sabinM1/VL53L8CX-carrier/reference docs/DB4884_VL53L8CX_Data_Brief.md

# DB4884 — VL53L8CX data brief

**Overview**
A summary brief highlighting the VL53L8CX capabilities: 60Hz framerate, 400cm range, low-power autonomous mode, and SPI/I2C connectivity for SLAM, gesture recognition, and laser-assisted autofocus (LAF). 

**System Diagram**
*[Image: Cover Image - Photograph of the top and bottom of the VL53L8CX module.]*
*[Image: Figure 1. VL53L8CX block diagram - High level internal component map showing the VCSEL, SPAD array, and control logic (identical to datasheet Figure 3).]*
