sabinM1/VL53L8CX-carrier/reference docs/Multizone_Cover_Window_Aperture_Calculator.md

# Multizone cover-window aperture calculator
[Image: A diagram illustrating Pitch and Roll angles relative to the sensor. The X dimension refers to the direction between emitter and transmitter. Pitch is the angle of deflection around the y-axis, and Roll is around the x-axis.][cite: 242]

**STMicroelectronics multizone Time-of-Flight aperture calculator**[cite: 242]

## Settings
| Item | Value | Description |
| :--- | :--- | :--- |
| **Sensor selection** | VL53L8 | Supported devices are VL53L5, L7, L8, L9[cite: 242] |
| **Coverglass thickness** | 1.00 | in millimeters[cite: 242] |
| **Coverglass refractive index** | 1.5 | no unit[cite: 242] |
| **Coverglass pitch y axis angle** | 0 | in degrees (not recommended)[cite: 242] |
| **Coverglass roll x axis angle** | 7 | in degrees[cite: 242] |
| **Airgap** | 0.81 | in millimeters[cite: 242] |
| **Airgap/gasket refractive index** | 1 | no unit[cite: 242] |
| **X, Y tolerances** | 300 | in micrometers[cite: 242] |
| **Z tolerance** | 0.2 | in millimeters[cite: 242] |
| **Rotation tolerance** | 0 | in degrees[cite: 242] |

## Results (Automatically Computed)
| Two circles (red circles) | Diameter (mm) | Circle center offset vs Optical axis (Xc) (mm) | Circle center offset vs Optical axis (Yc) (mm) |
| :--- | :--- | :--- | :--- |
| **Emitter** | 3.68 | 0.00 | 0.15[cite: 242] |
| **Receiver** | 3.64 | 0.00 | 0.14[cite: 242] |

| Single oval (blue shape) | Size (mm) | Circle center offset vs Optical axis (Xce) (mm) | Circle center offset vs Optical axis (Yce) (mm) |
| :--- | :--- | :--- | :--- |
| **Emitter** | 7.66 | 0.00 | 0.15[cite: 242] |
| **Receiver** | 3.68 | N/A | N/A[cite: 242] |

| Two rectangles (red) | X size (mm) | Y size (mm) | Rectangle center offset vs optical axis (Xc) (mm) | Rectangle center offset vs optical axis (Yc) (mm) |
| :--- | :--- | :--- | :--- | :--- |
| **Emitter** | 2.62 | 2.47 | 0.00 | 0.07[cite: 242] |
| **Receiver** | 2.59 | 2.44 | 0.00 | 0.07[cite: 242] |

| VL53L5CX/VL53L7/VL53L8 Single Rectangle | X size (mm) | Y size (mm) | Rectangle center offset vs optical axis (Xce) (mm) | Rectangle center offset vs optical axis (Yce) (mm) |
| :--- | :--- | :--- | :--- | :--- |
| **Aperture size** | 6.60 | 2.47 | 0.00 | 0.07[cite: 242] |
