sabinM1/VL53L8CX-carrier/reference docs/components/tps22918-q1.md

# TPS22918-Q1 — 5.5-V, 2-A, 52-mΩ On-Resistance Load Switch

Source file: `tps22918-q1.pdf`

## Features
- AEC-Q100 qualified
- Integrated single-channel load switch
- Qualified for automotive applications:
  - Device temperature grade 2: -40°C to +105°C ambient operating temperature range
- Functional safety capable
  - Documentation available to aid functional safety system design
- Input voltage range: 1 V to 5.5 V
- Low on-resistance (\(R_{ON}\)):
  - \(R_{ON} = 52\ \text{m}\Omega\) (typical) at \(V_{IN} = 5\ \text{V}\)
  - \(R_{ON} = 53\ \text{m}\Omega\) (typical) at \(V_{IN} = 3.3\ \text{V}\)
- 2-A maximum continuous switch current
- Low quiescent current:
  - \(8.3\ \mu\text{A}\) (typical) at \(V_{IN} = 3.3\ \text{V}\)
- Low-control input-threshold enables use of 1 V or higher GPIO
- Configurable Quick-Output Discharge (QOD)
- Configurable rise time with CT pin
- Small SOT23-6 package (DBV)
  - 2.9 mm × 2.8 mm, 0.95-mm pitch, 1.45-mm height (with leads)
- ESD performance tested per AEC-Q100
  - ±2-kV HBM and ±750-V CDM

## Applications
- Automotive electronics
- Infotainment
- Cluster
- ADAS (Advanced Driver Assistance Systems)

## Description
The TPS22918-Q1 is a single-channel load switch with both configurable rise time and configurable quick-output discharge. The device contains an N-channel MOSFET that operates over an input voltage range of 1 V to 5.5 V and supports a maximum continuous current of 2 A. The switch is controlled by an on/off input capable of interfacing directly with low-voltage control signals.

The configurable rise time reduces inrush current caused by large bulk load capacitances, reducing or eliminating power-supply droop. The TPS22918-Q1 features a configurable quick output discharge (QOD) pin that controls the fall time of the device to allow design flexibility for power down and sequencing.

The device is available in a small, leaded SOT-23 package (DBV) which allows visual inspection of solder joints. Characterized for operation over -40°C to +105°C free-air temperature range.

## Device Information

| Part Number | Package | Body Size (Nom) |
|---|---|---|
| TPS22918-Q1 | SOT-23 (6) | 2.90 mm × 1.60 mm |

## Pin Configuration and Functions

### DBV Package, 6-Pin SOT-23 (Top View)

| Pin | Name | Type | Description |
|---|---|---|---|
| 1 | VIN | I | Switch input. Place ceramic bypass capacitor(s) between this pin and GND. |
| 2 | GND | — | Device ground |
| 3 | ON | I | Active-high switch control input. Do not leave floating. |
| 4 | CT | O | Switch slew-rate control. Can be left floating. |
| 5 | QOD | O | Quick Output Discharge pin. Can be enabled by:<br>• External resistor between VOUT and QOD<br>• Tying QOD directly to VOUT using internal resistor \(R_{PD}\)<br>• Leaving pin disconnected to disable QOD |
| 6 | VOUT | O | Switch output |

## Absolute Maximum Ratings

Over operating free-air temperature range (unless otherwise noted).

| Parameter | Min | Max | Unit |
|---|---:|---:|---|
| \(V_{IN}\) input voltage | -0.3 | 6 | V |
| \(V_{OUT}\) output voltage | -0.3 | 6 | V |
| \(V_{ON}\) ON voltage | -0.3 | 6 | V |
| \(I_{MAX}\) maximum continuous switch current, \(T_A = 70°C\) | — | 2 | A |
| \(I_{MAX}\) maximum continuous switch current, \(T_A = 85°C\) | — | 1.5 | A |
| \(I_{PLS}\) maximum pulsed switch current, pulse < 300 µs, 2% duty cycle | — | 2.5 | A |
| \(T_J\) maximum junction temperature | — | 150 | °C |
| \(T_{stg}\) storage temperature | -65 | 150 | °C |

## ESD Ratings

| Rating | Value | Unit |
|---|---:|---|
| HBM per AEC Q100-002 | ±2000 | V |
| CDM per AEC Q100-011 | ±750 | V |

## Recommended Operating Conditions

Over operating free-air temperature range (unless otherwise noted).

| Parameter | Min | Max | Unit |
|---|---:|---:|---|
| \(V_{IN}\) input voltage | 1 | 5.5 | V |
| \(V_{ON}\) ON voltage | 0 | 5.5 | V |
| \(V_{OUT}\) output voltage | — | \(V_{IN}\) | V |
| \(V_{IH,ON}\) high-level input voltage, \(V_{IN}=1\ \text{V}\) to 5.5 V | 1 | 5.5 | V |
| \(V_{IL,ON}\) low-level input voltage, \(V_{IN}=1\ \text{V}\) to 5.5 V | 0 | 0.5 | V |
| \(T_A\) operating free-air temperature | -40 | 105 | °C |
| \(C_{IN}\) input capacitor | 1 | — | µF |

## Thermal Information

| Thermal Metric | DBV (SOT-23) 6 Pins | Unit |
|---|---:|---|
| \(R_{\theta JA}\) junction-to-ambient | 183.2 | °C/W |
| \(R_{\theta JC(top)}\) junction-to-case (top) | 151.6 | °C/W |
| \(R_{\theta JB}\) junction-to-board | 34.1 | °C/W |
| \(\Psi_{JT}\) junction-to-top characterization | 37.2 | °C/W |
| \(\Psi_{JB}\) junction-to-board characterization | 33.6 | °C/W |

## Electrical Characteristics

Unless otherwise noted, specifications apply over -40°C ≤ \(T_A\) ≤ +105°C (full). Typical values at \(T_A = 25°C\).

| Parameter | Test Conditions | \(T_A\) | Min | Typ | Max | Unit |
|---|---|---|---:|---:|---:|---|
| \(I_{Q,VIN}\) quiescent current | \(V_{IN}=5.5\ \text{V}\) | -40 to +105°C | — | 9.2 | 16 | µA |
| | \(V_{IN}=5\ \text{V}\) | | — | 8.7 | 16 | µA |
| | \(V_{IN}=3.3\ \text{V}\) | | — | 8.3 | 15 | µA |
| | \(V_{IN}=1.8\ \text{V}\) | | — | 10.2 | 17 | µA |
| | \(V_{IN}=1.2\ \text{V}\) | | — | 9.3 | 16 | µA |
| | \(V_{IN}=1\ \text{V}\) | | — | 8.9 | 15 | µA |
| \(I_{SD,VIN}\) shutdown current | \(V_{IN}=5.5\ \text{V}\) | -40 to +105°C | — | 0.5 | 5 | µA |
| | \(V_{IN}=5\ \text{V}\) | | — | 0.5 | 4.5 | µA |
| | \(V_{IN}=3.3\ \text{V}\) | | — | 0.5 | 3.5 | µA |
| | \(V_{IN}=1.8\ \text{V}\) | | — | 0.5 | 2.5 | µA |
| | \(V_{IN}=1.2\ \text{V}\) | | — | 0.4 | 2 | µA |
| | \(V_{IN}=1\ \text{V}\) | | — | 0.4 | 2 | µA |
| \(I_{ON}\) ON pin input leakage | \(V_{IN}=5.5\ \text{V}\), \(I_{OUT}=0\ \text{A}\) | -40 to +105°C | — | — | 0.1 | µA |
| \(R_{ON}\) on-resistance | \(V_{IN}=5.5\ \text{V}\), \(I_{OUT}=-200\ \text{mA}\) | 25°C | — | 51 | 59 | mΩ |
| | \(V_{IN}=5\ \text{V}\) | 25°C | — | 52 | 59 | mΩ |
| | \(V_{IN}=4.2\ \text{V}\) | 25°C | — | 52 | 59 | mΩ |
| | \(V_{IN}=3.3\ \text{V}\) | 25°C | — | 53 | 59 | mΩ |
| | \(V_{IN}=2.5\ \text{V}\) | 25°C | — | 53 | 61 | mΩ |
| | \(V_{IN}=1.8\ \text{V}\) | 25°C | — | 55 | 65 | mΩ |
| | \(V_{IN}=1.2\ \text{V}\) | 25°C | — | 64 | 77 | mΩ |
| | \(V_{IN}=1\ \text{V}\) | 25°C | — | 71 | 85 | mΩ |
| | \(V_{IN}=1\ \text{V}\) to 5.5 V | -40 to +105°C | — | — | 107 | mΩ |
| \(R_{PD}\) output pull-down resistance | \(V_{IN}=5\ \text{V}\), \(V_{ON}=0\ \text{V}\) | 25°C | — | 24 | — | Ω |
| | \(V_{IN}=3.3\ \text{V}\), \(V_{ON}=0\ \text{V}\) | 25°C | — | 25 | — | Ω |
| | \(V_{IN}=1.8\ \text{V}\), \(V_{ON}=0\ \text{V}\) | 25°C | — | 45 | — | Ω |
| | \(V_{IN}=1.8\ \text{V}\), \(V_{ON}=0\ \text{V}\) | -40 to +105°C | — | 60 | — | Ω |

## Switching Characteristics

See timing test circuit (Figure 21). \(V_{ON}=5\ \text{V}\), \(T_A=25°C\). Valid for power-up sequence where VIN is in steady state before ON is asserted high.

### \(V_{IN}=5\ \text{V}\)

| Parameter | Test Conditions | Min | Typ | Max | Unit |
|---|---|---|---:|---:|---|
| \(t_{ON}\) turn-on time | \(R_L=10\ \Omega\), \(C_{IN}=1\ \mu F\), \(C_{OUT}=0.1\ \mu F\), CT = 1000 pF | — | 1950 | — | µs |
| \(t_{OFF}\) turn-off time | same | — | 2 | — | µs |
| \(t_R\) \(V_{OUT}\) rise time | same | — | 2540 | — | µs |
| \(t_F\) \(V_{OUT}\) fall time | same | — | 2 | — | µs |
| \(t_D\) delay time | same | — | 690 | — | µs |

### \(V_{IN}=3.3\ \text{V}\)

| Parameter | Test Conditions | Min | Typ | Max | Unit |
|---|---|---|---:|---:|---|
| \(t_{ON}\) | same | — | 1430 | — | µs |
| \(t_{OFF}\) | same | — | 2 | — | µs |
| \(t_R\) | same | — | 1680 | — | µs |
| \(t_F\) | same | — | 2 | — | µs |
| \(t_D\) | same | — | 590 | — | µs |

### \(V_{IN}=1.8\ \text{V}\)

| Parameter | Test Conditions | Min | Typ | Max | Unit |
|---|---|---|---:|---:|---|
| \(t_{ON}\) | same | — | 965 | — | µs |
| \(t_{OFF}\) | same | — | 2 | — | µs |
| \(t_R\) | same | — | 960 | — | µs |
| \(t_F\) | same | — | 2 | — | µs |
| \(t_D\) | same | — | 480 | — | µs |

### \(V_{IN}=1\ \text{V}\)

| Parameter | Test Conditions | Min | Typ | Max | Unit |
|---|---|---|---:|---:|---|
| \(t_{ON}\) | same | — | 725 | — | µs |
| \(t_{OFF}\) | same | — | 3 | — | µs |
| \(t_R\) | same | — | 560 | — | µs |
| \(t_F\) | same | — | 2 | — | µs |
| \(t_D\) | same | — | 430 | — | µs |

## Typical DC Characteristics
- Quiescent current vs input voltage
- Shutdown current vs input voltage
- On-resistance vs temperature
- On-resistance vs input voltage
- On-resistance vs output current
- Hysteresis voltage vs input voltage

## Typical AC Characteristics
- Rise time vs input voltage
- Delay time vs input voltage
- Fall time vs input voltage
- Turnoff time vs input voltage
- Turnon time vs input voltage
- Rise/fall waveforms at \(V_{IN}\) = 5 V, 3.3 V, 1.8 V, 1 V

## Detailed Description

### Overview
The TPS22918-Q1 is a 5.5-V, 2-A load switch in a 6-pin SOT-23 package. It implements a low-resistance N-channel MOSFET to reduce dropout voltage. The configurable slew rate reduces or eliminates supply droop caused by large inrush currents. The QOD pin allows configuration of the VOUT discharge rate once the switch is disabled. During shutdown, leakage currents are very low. Integrated control logic, driver, charge pump, and output discharge FET reduce solution size and BOM count.

### Functional Block Diagram
- VIN → N-channel MOSFET → VOUT
- Charge pump drives the gate
- Control logic from ON pin
- CT pin sets slew rate
- QOD pin controls output discharge

### Feature Description

#### On and Off Control
The ON pin controls the switch state. ON is active high and has a low threshold, making it compatible with standard GPIO logic thresholds. It can interface with any microcontroller with 1 V or higher GPIO voltage. This pin cannot be left floating and must be driven high or low.

#### Quick Output Discharge (QOD)
The QOD pin can be configured in three ways:
1. **QOD pin shorted to VOUT** — discharge rate controlled by internal \(R_{PD}\).
2. **QOD pin connected to VOUT via external resistor \(R_{EXT}\)** — total QOD resistance:
   \[
   R_{QOD}=R_{PD}+R_{EXT}
   \]
3. **QOD pin left open** — QOD disabled.

#### Adjustable Rise Time (CT)
A capacitor to GND on the CT pin sets the slew rate. The CT capacitor must be rated for 25 V or above.

Approximate relationship:
\[
\text{SR}=0.55\times C_T+30
\]
where SR is slew rate in µs/V and \(C_T\) is capacitance in pF.

Rise time can be calculated by multiplying input voltage by the slew rate.

**Rise Time Table (Typical, 25°C, \(C_L=0.1\ \mu F\), \(C_{IN}=1\ \mu F\), \(R_L=10\ \Omega\), 25-V X7R 10% ceramic on CT):**

| \(C_T\) (pF) | \(V_{IN}\)=5 V | 3.3 V | 2.5 V | 1.8 V | 1.5 V | 1.2 V | 1.0 V | Unit |
|---|---:|---:|---:|---:|---:|---:|---:|---|
| 0 | 135 | 95 | 75 | 65 | 60 | 50 | 45 | µs |
| 220 | 650 | 450 | 350 | 260 | 220 | 185 | 160 | µs |
| 470 | 1260 | 850 | 655 | 480 | 415 | 340 | 300 | µs |
| 1000 | 2540 | 1680 | 1300 | 960 | 810 | 660 | 560 | µs |
| 2200 | 5435 | 3580 | 2760 | 2020 | 1715 | 1390 | 1220 | µs |
| 4700 | 12050 | 7980 | 6135 | 4485 | 3790 | 3120 | 2735 | µs |
| 10000 | 26550 | 17500 | 13460 | 9790 | 8320 | 6815 | 5950 | µs |

**Recommended CT Capacitor Voltage Rating:**

| \(V_{IN}\) (V) | Recommended CT Capacitor Voltage Rating (V) |
|---|---|
| 1 V to 1.2 V | 10 |
| 1.2 V to 4 V | 16 |
| 4 V to 5.5 V | 20 |

Note: If using \(V_{IN}=1.2\ \text{V}\) or 4 V, use the higher voltage rating.

### Device Functional Modes

| ON | QOD Configuration | VOUT Connection |
|---|---|---|
| L | QOD connected to VOUT with \(R_{EXT}\) | GND (via \(R_{EXT}+R_{PD}\)) |
| L | QOD tied to VOUT directly | GND (via \(R_{PD}\)) |
| L | QOD left open | Open |
| H | Any valid QOD configuration | VIN |

## Application and Implementation

### Typical Application
Power supply → VIN of TPS22918-Q1 → VOUT to downstream module.
- \(C_{IN}\) between VIN and GND
- \(C_L\) and \(R_L\) on VOUT
- CT capacitor to GND
- QOD configuration

### Design Requirements (Example)

| Design Parameter | Example Value |
|---|---|
| \(V_{IN}\) | 5 V |
| Load current | 2 A |
| \(C_L\) | 22 µF |
| \(t_F\) | 4 ms |
| Maximum acceptable inrush current | 400 mA |

### Detailed Design Procedure

#### Input Capacitor (\(C_{IN}\))
- A 1-µF ceramic capacitor placed close to VIN and GND is usually sufficient.
- For heavy loads, \(C_{IN}\) about 10× \(C_L\) is recommended to avoid excessive voltage drop.

#### Output Capacitor (\(C_L\)) (Optional)
- \(C_{IN} > C_L\) is highly recommended because of the MOSFET body diode.
- A \(C_L > C_{IN}\) can cause \(V_{OUT}\) to exceed \(V_{IN}\) when the supply is removed, causing current through the body diode from VOUT to VIN.
- A \(C_{IN}\):\(C_L\) ratio of 10:1 is recommended.

#### Shutdown Sequencing During Unexpected System Power Loss
- The QOD function can manage power-down sequencing in the event of unexpected system power loss (e.g., battery removal).
- Determine power-down order; check voltage/timing margins.
- Use QOD table to select \(C_{OUT}\) and \(R_{QOD}\) so fall times match the desired sequence.

Example (4 ms fall time, \(C_L=22\ \mu F\), \(V_{IN}=5\ \text{V}\)):
\[
5.5\ \text{V}=4.5\ \text{V}\times e^{-(4\text{ms})/(R\times 22\mu F)}
\]
\[
R_{QOD}=83.333\ \Omega
\]
With \(R_{PD}\approx 25\ \Omega\) at \(V_{IN}=5\ \text{V}\):
\[
83.333=R_{PD}+R_{EXT}\Rightarrow R_{EXT}=58.333\ \Omega
\]

#### \(V_{IN}\) to VOUT Voltage Drop
\[
\Delta V=I_{LOAD}\times R_{ON}
\]
Choose \(I_{LOAD}\) such that the \(I_{MAX}\) specification is not violated.

#### Inrush Current
\[
I_{INRUSH}=C_L\times\frac{dV_{OUT}}{dt}
\]
Example: \(C_L=22\ \mu F\), \(\Delta V=4\ \text{V}\), \(I_{INRUSH}\le 400\ \text{mA}\):
\[
dt\ge 220\ \mu s
\]
Choose CT yielding rise time > 220 µs. At \(V_{IN}=5\ \text{V}\), \(C_T=220\ \text{pF}\) gives ~650 µs typical rise time:
\[
I_{INRUSH}=22\ \mu F\times 4\ \text{V}/650\ \mu s\approx 135\ \text{mA}
\]

## Power Supply Recommendations
- \(V_{IN}\) range: 1 V to 5.5 V.
- Supply must be well regulated and placed close to the device with the recommended 1-µF bypass capacitor.
- If supply is more than a few inches away, additional bulk capacitance may be required (1 µF electrolytic, tantalum, or ceramic may suffice).

## Layout

### Layout Guidelines
- VIN and VOUT traces should be as short and wide as possible.
- Bypass VIN to GND with low-ESR ceramic capacitor (1 µF X5R/X7R), placed close to pins.
- Bypass VOUT to GND with low-ESR ceramic capacitor, typically one-tenth of the VIN bypass capacitor, placed close to pins.

### Thermal Considerations
- Maximum junction temperature must be ≤150°C.
- Maximum allowable power dissipation:
  \[
  P_{D(MAX)}=\frac{T_{J(MAX)}-T_A}{\theta_{JA}}
  \]
  where \(T_{J(MAX)}=150°C\) and \(\theta_{JA}\) is from the Thermal Information table.

## Device and Documentation Support

### Device Support
- TPS22918 PSpice Transient Model: SLVMB16

### Related Documentation
- TPS22918 5.5-V, 2-A, 50-mΩ On-Resistance Load Switch Evaluation Module, SLVUAP0
- Quiescent Current vs Shutdown Current for Load Switch Power Consumption, SLVA757
- Fundamentals of On-Resistance in Load Switches, SLVA771

### Trademarks
E2E is a trademark of Texas Instruments. All other trademarks are property of their respective owners.

### Electrostatic Discharge Caution
This integrated circuit can be damaged by ESD. Handle with appropriate precautions. ESD damage can range from subtle performance degradation to complete device failure.

## Mechanical, Packaging, and Orderable Information

### Package Option Addendum

| Orderable Part Number | Status | Package | Pins | Qty | Carrier | RoHS | Lead Finish | MSL/Peak Reflow | Op Temp (°C) | Part Marking |
|---|---|---|---|---:|---|---|---|---|---|---|
| TPS22918TDBVRQ1 | Active | SOT-23 (DBV) | 6 | 3000 | LARGE T&R | Yes | SN | Level-3-260C-168 HR | -40 to 105 | 13NW |
| TPS22918TDBVRQ1.A | Active | SOT-23 (DBV) | 6 | 3000 | LARGE T&R | Yes | SN | Level-3-260C-168 HR | -40 to 105 | 13NW |
| TPS22918TDBVTQ1 | Active | SOT-23 (DBV) | 6 | 250 | SMALL T&R | Yes | SN | Level-3-260C-168 HR | -40 to 105 | 13NW |
| TPS22918TDBVTQ1.A | Active | SOT-23 (DBV) | 6 | 250 | SMALL T&R | Yes | SN | Level-3-260C-168 HR | -40 to 105 | 13NW |

### Other Qualified Versions
- Catalog: TPS22918

### Tape and Reel Information (Nominal)

| Device | Package | Pins | SPQ | Reel Dia (mm) | Reel Width W1 (mm) | A0 (mm) | B0 (mm) | K0 (mm) | P1 (mm) | W (mm) | Pin1 Quadrant |
|---|---|---:|---:|---:|---:|---:|---:|---:|---:|---:|---|
| TPS22918TDBVRQ1 | SOT-23 (DBV) | 6 | 3000 | 178.0 | 9.0 | 3.23 | 3.17 | 1.37 | 4.0 | 8.0 | Q3 |
| TPS22918TDBVRQ1 | SOT-23 (DBV) | 6 | 3000 | 180.0 | 8.4 | 3.2 | 3.2 | 1.4 | 4.0 | 8.0 | Q3 |
| TPS22918TDBVTQ1 | SOT-23 (DBV) | 6 | 250 | 178.0 | 9.0 | 3.23 | 3.17 | 1.37 | 4.0 | 8.0 | Q3 |
| TPS22918TDBVTQ1 | SOT-23 (DBV) | 6 | 250 | 180.0 | 8.4 | 3.2 | 3.2 | 1.4 | 4.0 | 8.0 | Q3 |

### Tape and Reel Box Dimensions (Nominal)

| Device | Package | Pins | SPQ | Length (mm) | Width (mm) | Height (mm) |
|---|---|---:|---:|---:|---:|---:|
| TPS22918TDBVRQ1 | SOT-23 (DBV) | 6 | 3000 | 190.0 | 190.0 | 30.0 |
| TPS22918TDBVRQ1 | SOT-23 (DBV) | 6 | 3000 | 210.0 | 185.0 | 35.0 |
| TPS22918TDBVTQ1 | SOT-23 (DBV) | 6 | 250 | 190.0 | 190.0 | 30.0 |
| TPS22918TDBVTQ1 | SOT-23 (DBV) | 6 | 250 | 210.0 | 185.0 | 35.0 |

### Package Notes
- Linear dimensions in millimeters; values in parentheses are for reference only.
- Dimensioning and tolerancing per ASME Y14.5M.
- Body dimensions do not include mold flash/protrusion; max 0.25 mm per side.
- Leads 1,2,3 may be wider than leads 4,5,6 for package orientation.
- Reference JEDEC MO-178.
