sabinM1/VL53L8CX-carrier/reference docs/components/Taiyo_Yuden_MLCC_Catalog.md

# Taiyo Yuden Multilayer Ceramic Capacitors — Catalog Excerpt

Source file: `Taiyo Yuden_1102023_MC_mlcc_all_e.pdf`

## Reminders
- Product information is as of October 2021 and subject to change.
- Obtain and approve individual product specifications before use.
- Validate products in actual equipment and operating conditions.
- Taiyo Yuden is not responsible for damages caused by use outside specified conditions.
- Products are intended for general-purpose/standard use unless otherwise specified.

## Equipment Intended for Use
Product series are categorized by quality grade and intended application. Contact Taiyo Yuden before use in equipment requiring higher quality/reliability.

| Application | Product Series | Quality Grade |
|---|---|---|
| Automotive (POWERTRAIN, SAFETY) | A1 | 1 |
| Automotive (BODY & CHASSIS, INFOTAINMENT) | C2 | 2 |
| Industrial / Telecommunications infrastructure | B2 | 2 |
| Medical GHTF Class C (Japan Class III) | M2 | 2 |
| Medical GHTF Class A/B (Japan Class I/II) | L3 | 3 |
| Consumer general electronic equipment | S3 | 3 |

## Equipment Requiring Inquiry
Contact Taiyo Yuden before use in:
- Transportation equipment
- Traffic signal equipment
- Disaster/crime prevention equipment
- Medical devices classified as GHTF Class C (Japan Class III)
- Highly public information network equipment
- Other equipment requiring high quality/reliability

## Equipment Prohibited for Use
Do not use in:
- Aerospace equipment
- Aviation equipment (with limited exceptions)
- GHTF Class D / implantable medical devices
- Power generation control equipment
- Undersea equipment
- Military equipment
- Other extremely high-safety/reliability applications

## Part Number System
Example structure:
`MC A S 06 3 S B 7101 [F] C A01`

| Field | Meaning |
|---|---|
| (1) Series | MC = multilayer ceramic capacitor; MCAS/MCAR/MCJC/MCRL for automotive |
| (2) Category | C = automotive body/chassis/infotainment, quality grade 2 |
| (3) Rated voltage | A=4 V, J=6.3 V, L=10 V, E=16 V, T=25 V, G=35 V, U=50 V, H=100 V, Q=250 V, S=630 V |
| (4) Dimension | 06=0.6×0.3, 10=1.0×0.5, 16=1.6×0.8, 21=2.0×1.25, 31=3.2×1.6, 32=3.2×2.5, 45=4.5×3.2 |
| (5) Type | A = 2 terminals; J = soft termination; R = LW reversal |
| (6) Features | S = standard; R = high frequency/low loss; C = internal soft termination; L = low ESL |
| (7) Thickness | 3=0.3 mm, 5=0.5 mm, 7=0.7 mm, 8=0.8 mm, 9=0.85 mm, Q=1.15 mm, G=1.25 mm, L=1.6 mm, N=1.9 mm, M=2.5 mm |
| (8) Temperature characteristic | B5=X5R, B7=X7R, C6=X6S, C7=X7S, D7=X7T, CG/C0G, CH, CJ, CK |
| (9) Capacitance | 3-digit code, R = decimal point |
| (10) Tolerance | K=±10%, M=±20%, etc. |
| (11) Packaging | F, R, T, P |

## Temperature Characteristics

| Code | Standard | Temperature Range | Capacitance Change | Tolerance |
|---|---|---|---:|---|
| B5 | EIA X5R | -55°C to +85°C | ±15% | K ±10%, M ±20% |
| C6 | EIA X6S | -55°C to +105°C | ±22% | K ±10%, M ±20% |
| B7 | EIA X7R | -55°C to +125°C | ±15% | K ±10%, M ±20% |
| C7 | EIA X7S | -55°C to +125°C | ±22% | K ±10%, M ±20% |
| D7 | EIA X7T | -55°C to +125°C | +22%/-33% | K ±10%, M ±20% |

Temperature compensating types:
- CG/C0G: 0 ± 30 ppm/°C
- CH/C0H: 0 ± 60 ppm/°C
- CJ/C0J: 0 ± 120 ppm/°C
- CK/C0K: 0 ± 250 ppm/°C

## Nominal Capacitance Codes
Examples: 0R5 = 0.5 pF; 010 = 1 pF; 100 = 10 pF; 101 = 100 pF; 102 = 1 nF; 103 = 10 nF; 104 = 100 nF; 105 = 1 µF; 106 = 10 µF; 107 = 100 µF.

## Packaging Codes
- F: φ178 mm taping, 2 mm pitch
- R: φ178 mm embossed taping, 4 mm pitch
- T: φ178 mm taping, 4 mm pitch
- P: 3225 type, thickness code M, 1000 pcs/reel

## Part Number Tables
The catalog includes extensive part-number tables for:
- 0603 type, X7R, 0.3 mm thickness
- 1005 type, X5R, 0.5 mm thickness
- 1608 type, X5R/X7R, 0.8 mm thickness
- 2012 type, X5R/X7R, 1.25 mm thickness
- 3216 type, X5R/X7R, 1.6 mm thickness
- 3225 type, X5R/X7R, 2.5 mm and 1.9 mm thickness
- Soft-termination MLCCs
- LW reversal low-ESL capacitors

## Key Electrical/Test Requirements
- Operating temperature range: -55°C to +125°C for Class 1; Class 2 depends on dielectric.
- Storage: ≤30°C, ≤70% RH recommended; use within 6 months of delivery.
- Rated voltage: 4 V to 630 V depending on series.
- Withstanding voltage: Class 1 = 3× rated (or 2× for high-frequency type); Class 2 = 2.5× rated.
- Insulation resistance: Class 1 ≥10,000 MΩ; Class 2 ≥10,000 MΩ for C≤0.047 µF, or 500 MΩ·µF for C>0.047 µF.
- Capacitance tolerance: Class 1 ±0.25 pF, ±0.5 pF, ±5%; Class 2 ±10%, ±20%.
- Q/DF: Class 1 Q≥400+20C (C<30 pF), Q≥1000 (C≥30 pF); Class 2 DF ≤2.5% typical.
- Endurance, temperature cycling, humidity, soldering heat, vibration, mechanical shock, board flex tested per AEC-Q200 and IEC standards.
