sabinM1/VL53L8CX-carrier/reference docs/components/TDK_MLCC_Commercial_Capacitors.md

# TDK MLCC — Commercial Grade General Capacitors (Up to 75 V), C Series

Source file: `mlcc_commercial_general_en.pdf`

## Series Overview
General-purpose surface-mount multilayer ceramic chip capacitors. Monolithic structure gives high mechanical strength, high reliability, low ESR, and low ESL. Capacitance range up to 220 µF.

## Features
- Superior mechanical strength and high reliability
- Outstanding frequency characteristics: low ESR, low ESL
- Low self-heating and high ripple resistance due to low ESR
- No polarity

## Applications
- General electronic equipment
- Mobile devices
- Servers, PCs, tablets
- Power supply circuits

## Shape and Dimensions

| Type | L (mm) | W (mm) | T (mm) | B min (mm) | G min (mm) |
|---|---:|---:|---:|---:|---:|
| C0402 [CC01005] | 0.40 ± 0.02 | 0.20 ± 0.02 | 0.20 ± 0.02 | 0.07 | 0.14 |
| C0603 [CC0201] | 0.60 ± 0.03 | 0.30 ± 0.03 | 0.30 ± 0.03 | 0.10 | 0.20 |
| C1005 [CC0402] | 1.00 ± 0.05 | 0.50 ± 0.05 | 0.50 ± 0.05 | 0.30 | — |
| C1608 [CC0603] | 1.60 ± 0.10 | 0.80 ± 0.10 | 0.80 ± 0.10 | 0.30 | — |
| C2012 [CC0805] | 2.00 ± 0.20 | 1.25 ± 0.20 | 1.25 ± 0.20 | 0.50 | — |
| C3216 [CC1206] | 3.20 ± 0.20 | 1.60 ± 0.20 | 1.60 ± 0.20 | 1.00 | — |
| C3225 [CC1210] | 3.20 ± 0.40 | 2.50 ± 0.30 | 2.50 ± 0.30 | — | — |
| C4532 [CC1812] | 4.50 ± 0.40 | 3.20 ± 0.40 | 3.20 ± 0.40 | — | — |
| C5750 [CC2220] | 5.70 ± 0.40 | 5.00 ± 0.40 | 2.80 ± 0.30 | — | — |

## Temperature Characteristics

| Code | Capacitance Change | Temperature Range |
|---|---|---|
| C0G | 0 ± 30 ppm/°C | -55°C to +125°C |
| X7R | ±15% | -55°C to +125°C |
| X7S | ±22% | -55°C to +125°C |
| X7T | +22% / -33% | -55°C to +125°C |
| X6S | ±22% | -55°C to +105°C |
| X5R | ±15% | -55°C to +85°C |
| X5S | ±22% | -55°C to +85°C |

## Rated Voltage Codes

| Code | Voltage |
|---|---:|
| 0E | 2.5 V |
| 0G | 4 V |
| 0J | 6.3 V |
| 1A | 10 V |
| 1C | 16 V |
| 1E | 25 V |
| 1V | 35 V |
| 1H | 50 V |
| 1N | 75 V |

## Capacitance Tolerance

| Code | Tolerance |
|---|---|
| B | ±0.10 pF |
| C | ±0.25 pF |
| D | ±0.50 pF |
| F | ±1% |
| G | ±2% |
| J | ±5% |
| K | ±10% |
| M | ±20% |

## Nominal Thickness Codes
020 = 0.20 mm; 030 = 0.30 mm; 050 = 0.50 mm; 060 = 0.60 mm; 080 = 0.80 mm; 085 = 0.85 mm; 115 = 1.15 mm; 125 = 1.25 mm; 160 = 1.60 mm; 200 = 2.00 mm; 230 = 2.30 mm; 250 = 2.50 mm; 280 = 2.80 mm; 320 = 3.20 mm.

## Packaging Style
- A: 178 mm reel, 4 mm pitch
- B: 178 mm reel, 2 mm pitch
- K: 178 mm reel, 8 mm pitch

## Capacitance Range Summary
The catalog contains detailed capacitance range charts and tables for COG, X5R, X6S, X7R, X7S, X5S, X7T across sizes from 0402 to 5750. Representative ranges:
- COG: 1 pF to 220 nF depending on size/voltage
- X5R: 100 pF to 220 µF
- X6S: 2.2 nF to 220 µF
- X7R: 100 pF to 47 µF
- X7S: 100 nF to 47 µF
- X7T: 10 µF to 220 µF

## Notes
- Gray entries in original tables are NRND (Not Recommended for New Designs).
- Capacitance values outside E-6 series available on request.
- Dimensions are typical; check product page for actual values.
