sabinM1/VL53L8CX-carrier/reference docs/components/Yageo_AC_AEC-Q200_Resistors.md

# Yageo AC Series — AEC-Q200 Chip Resistors

Source file: `PYu-AC_51_RoHS_L_11.pdf`

## Scope
AC0201 to AC2512 chip resistors with lead-free terminations, thick-film process.

## Applications
- All general-purpose applications
- Car electronics
- Industrial applications

## Features
- AEC-Q200 qualified
- MSL 1
- Soldering compliant with J-STD-020D
- Halogen-free epoxy
- RoHS compliant
- Pb-glass exempted by RoHS
- High component and equipment reliability
- 100% automatic optical inspection before taping

## Ordering Information — Global Part Number
Format:
`AC XXXX X X X X XXXX L`

| Field | Meaning |
|---|---|
| (1) Size | 0201/0402/0603/0805/1206/1210/1218/2010/2512 |
| (2) Tolerance | B=±0.1% low TCR; D=±0.5%; F=±1%; J=±5% |
| (3) Packaging | R=paper taping reel; K=embossed taping reel |
| (4) TCR | E=±50 ppm/°C |
| (5) Reel | 07=7-in standard; 7W=7-in 2× power; 13=13-in; 3W=13-in 2× power |
| (6) Resistance | 1 Ω–22 MΩ; R/K/M = decimal point |
| (7) Default | B = bulk AOI ordering only |

Example: `AC0402FR-07100KL` = AC0402, ±1%, 7-in reel, 100 kΩ.

## Marking
- AC0201/0402: no marking
- AC0603/0805/1206/1210/2010/2512:
  - E-24 ±5%: 3 digits
  - E-96 ±1%, ±0.5%: E-96 marking
- AC0805/1206/1210/2010/2512:
  - ±1%, ±0.5%: 4 digits
- AC1218:
  - E-24 ±5%: 3 digits
  - ±1%, ±0.5%: 4 digits

## Construction
Automotive-grade ceramic body, internal metal electrodes, resistive glaze, protective glass, laser trimming, protective overcoat, Ni/matte tin terminations.

## Dimensions

| Type | L (mm) | W (mm) | H (mm) | I1 (mm) | I2 (mm) |
|---|---:|---:|---:|---:|---:|
| AC0201 | 0.60 ± 0.03 | 0.30 ± 0.03 | 0.23 ± 0.03 | 0.12 ± 0.05 | 0.15 ± 0.05 |
| AC0402 | 1.00 ± 0.05 | 0.50 ± 0.05 | 0.32 ± 0.05 | 0.20 ± 0.10 | 0.25 ± 0.10 |
| AC0603 | 1.60 ± 0.10 | 0.80 ± 0.10 | 0.45 ± 0.10 | 0.25 ± 0.15 | 0.25 ± 0.15 |
| AC0805 | 2.00 ± 0.10 | 1.25 ± 0.10 | 0.50 ± 0.10 | 0.35 ± 0.20 | 0.35 ± 0.20 |
| AC1206 | 3.10 ± 0.10 | 1.60 ± 0.10 | 0.55 ± 0.10 | 0.45 ± 0.20 | 0.45 ± 0.20 |
| AC1210 | 3.10 ± 0.10 | 2.60 ± 0.15 | 0.55 ± 0.10 | 0.45 ± 0.15 | 0.50 ± 0.20 |
| AC1218 | 3.10 ± 0.10 | 4.60 ± 0.10 | 0.55 ± 0.10 | 0.45 ± 0.20 | 0.40 ± 0.20 |
| AC2010 | 5.00 ± 0.10 | 2.50 ± 0.15 | 0.55 ± 0.10 | 0.55 ± 0.15 | 0.55 ± 0.20 |
| AC2512 | 6.35 ± 0.10 | 3.10 ± 0.15 | 0.55 ± 0.10 | 0.60 ± 0.20 | 0.60 ± 0.20 |

## Electrical Characteristics (Representative)

| Type | Power | Operating Temp | Max Working Voltage | Max Overload Voltage | Resistance Range | TCR |
|---|---:|---|---:|---:|---|---|
| AC0201 | 1/20 W | -55°C to +155°C | 25 V | 50 V | 1 Ω–10 MΩ | -100/+350 ppm/°C |
| AC0402 | 1/16 W | -55°C to +155°C | 50 V | 100 V | 1 Ω–22 MΩ | ±200/±100 ppm/°C |
| AC0603 | 1/10 W | -55°C to +155°C | 75 V | 150 V | 1 Ω–22 MΩ | ±200/±100 ppm/°C |
| AC0805 | 1/8 W | -55°C to +155°C | 150 V | 300 V | 1 Ω–22 MΩ | ±200/±100 ppm/°C |
| AC1206 | 1/4 W | -55°C to +155°C | 200 V | 400 V | 1 Ω–10 MΩ | ±200/±100 ppm/°C |
| AC1210 | 1/2 W | -55°C to +155°C | 200 V | 500 V | 1 Ω–10 MΩ | ±200/±100 ppm/°C |
| AC1218 | 1 W / 1.5 W | -55°C to +155°C | 200 V | 500 V | 1 Ω–1 MΩ | ±200/±100 ppm/°C |
| AC2010 | 3/4 W / 1.25 W | -55°C to +155°C | 200 V | 500 V | 1 Ω–22 MΩ | ±200/±100 ppm/°C |
| AC2512 | 1 W / 2 W | -55°C to +155°C | 200 V | 500 V | 1 Ω–22 MΩ | ±200/±100 ppm/°C |

Low-TCR versions: ±50 ppm/°C, resistance range 10 Ω to 1 MΩ depending on size and power.

## Packing Style and Quantity

| Size | Paper reel 7-in | Paper reel 13-in | Embossed 7-in | Embossed 13-in |
|---|---:|---:|---:|---:|
| AC0201 | 10,000 | 50,000 | — | — |
| AC0402 | 10,000 | 50,000 | — | — |
| AC0603 | 5,000 | 20,000 | — | — |
| AC0805 | 5,000 | 20,000 | — | — |
| AC1206 | 5,000 | 20,000 | — | — |
| AC1210 | 5,000 | 20,000 | — | — |
| AC1218 | — | — | 4,000 | 16,000 |
| AC2010 | — | — | 4,000 | 16,000 |
| AC2512 | — | — | 4,000 | 16,000 |

## Tests and Requirements
AEC-Q200 tests include:
- High-temperature exposure
- Moisture resistance
- Biased humidity
- Operational life
- Resistance to soldering heat
- Thermal shock
- ESD
- Solderability
- Board flex
- TCR
- Short-time overload
- FOS (sulfur resistance)
