sabinM1/VL53L8CX-carrier/reference docs/components/Yageo_RC_L_General_Purpose_Resistors.md

# Yageo RC_L Series — General-Purpose Chip Resistors

Source file: `PYU-RC_GROUP_51_ROHS_L.pdf`

## Scope
RC series chip resistors with lead-free terminations, thick-film process.

## Applications
All general-purpose applications.

## Features
- Halogen-free epoxy
- RoHS compliant
- Lead-free terminations meet RoHS requirements
- Pb-glass in electrodes/resistor element/glass exempted by RoHS
- High component and equipment reliability
- Saves PCB space
- MSL class: MSL 1

## Ordering Information — Global Part Number
Format:
`RC XXXXX X X X X XXXX L`

| Field | Meaning |
|---|---|
| (1) Size | 0075/0100/0201/0402/0603/0805/1206/1210/1218/2010/2512 |
| (2) Tolerance | B=±0.1%, D=±0.5%, F=±1.0%, J=±5.0% |
| (3) Packaging | R=paper taping reel; K=embossed taping reel; S=ESD-safe reel (0075/0100 only) |
| (4) TCR | Based on spec |
| (5) Reel/power | 07=7-in standard; 10=10-in; 13=13-in; 7W=7-in 2× standard power; 7D=7-in 2× standard quantity; 7N=7-in ESD-safe; 3W=13-in 2× standard power |
| (6) Resistance | 2–4 digits; R/K/M = decimal point; e.g. 97R6=97.6 Ω, 9K76=9.76 kΩ, 1M=1 MΩ |
| (7) Default | L |

Example: `RC0402JR-07100KL` = RC0402, ±5%, 7-in reel, 100 kΩ.

## Marking
- RC0075/0100/0201/0402: no marking
- RC0603:
  - 1%, 0.5%, E24 exception values: 3 digits
  - 1%, 0.5%, E96: EIA-96 marking
  - 5%, E24: 3 digits
- RC0805/1206/1210/2010/2512:
  - 1%, 0.5%: 4 digits
  - 5%: 3 digits
- RC1218:
  - E-24 ±5%: 3 digits
  - E-24/E-96 ±1%, ±0.5%: 4 digits

## Construction
High-grade ceramic body, internal metal electrodes, thick-film resistive element, laser trimmed, protective epoxy coat, matte tin over Ni barrier terminations.

## Dimensions

| Type | L (mm) | W (mm) | H (mm) | l1 (mm) | l2 (mm) |
|---|---:|---:|---:|---:|---:|
| RC0075 | 0.30 ± 0.01 | 0.15 ± 0.01 | 0.13 ± 0.01 | 0.08 ± 0.03 | 0.08 ± 0.03 |
| RC0100 | 0.40 ± 0.02 | 0.20 ± 0.02 | 0.13 ± 0.02 | 0.10 ± 0.03 | 0.10 ± 0.03 |
| RC0201 | 0.60 ± 0.03 | 0.30 ± 0.03 | 0.23 ± 0.03 | 0.10 ± 0.05 | 0.15 ± 0.05 |
| RC0402 | 1.00 ± 0.05 | 0.50 ± 0.05 | 0.35 ± 0.05 | 0.20 ± 0.10 | 0.25 ± 0.10 |
| RC0603 | 1.60 ± 0.10 | 0.80 ± 0.10 | 0.45 ± 0.10 | 0.25 ± 0.15 | 0.25 ± 0.15 |
| RC0805 | 2.00 ± 0.10 | 1.25 ± 0.10 | 0.50 ± 0.10 | 0.35 ± 0.20 | 0.35 ± 0.20 |
| RC1206 | 3.10 ± 0.10 | 1.60 ± 0.10 | 0.55 ± 0.10 | 0.45 ± 0.20 | 0.45 ± 0.20 |
| RC1210 | 3.10 ± 0.10 | 2.60 ± 0.15 | 0.55 ± 0.10 | 0.45 ± 0.15 | 0.50 ± 0.20 |
| RC1218 | 3.10 ± 0.10 | 4.60 ± 0.10 | 0.55 ± 0.10 | 0.45 ± 0.20 | 0.40 ± 0.20 |
| RC2010 | 5.00 ± 0.10 | 2.50 ± 0.15 | 0.55 ± 0.10 | 0.60 ± 0.20 | 0.55 ± 0.20 |
| RC2512 | 6.35 ± 0.10 | 3.10 ± 0.15 | 0.55 ± 0.10 | 0.60 ± 0.20 | 0.60 ± 0.20 |

## Electrical Characteristics (Representative)

| Type | Power | Operating Temp | Max Working Voltage | Max Overload Voltage | Resistance Range | TCR |
|---|---:|---|---:|---:|---|---|
| RC0201 | 1/20 W | -55°C to +125°C | 25 V | 50 V | 1 Ω–100 MΩ | -100 to +350 ppm/°C |
| RC0402 | 1/16 W | -55°C to +155°C | 50 V | 100 V | 1 Ω–100 MΩ | ±200/±100 ppm/°C |
| RC0603 | 1/10 W | -55°C to +155°C | 75 V | 150 V | 1 Ω–22 MΩ | ±200/±100 ppm/°C |
| RC0805 | 1/8 W | -55°C to +155°C | 150 V | 300 V | 1 Ω–100 MΩ | ±200/±100 ppm/°C |
| RC1206 | 1/4 W | -55°C to +155°C | 200 V | 400 V | 1 Ω–100 MΩ | ±200/±100 ppm/°C |
| RC1210 | 1/2 W | -55°C to +155°C | 200 V | 500 V | 1 Ω–100 MΩ | ±200/±100 ppm/°C |
| RC1218 | 1 W | -55°C to +155°C | 200 V | 500 V | 1 Ω–1 MΩ | ±200/±100 ppm/°C |
| RC2010 | 3/4 W | -55°C to +155°C | 200 V | 500 V | 1 Ω–22 MΩ | ±200/±100 ppm/°C |
| RC2512 | 1 W / 2 W | -55°C to +155°C | 200 V | 500 V | 1 Ω–22 MΩ | ±200/±100 ppm/°C |

Jumper criteria: <50 mΩ, rated current 0.5 A to 10 A depending on size.

## Rated Voltage
\[
V=\sqrt{P\times R}
\]
or maximum working voltage, whichever is less.

## Power Derating
Rated power at 70°C; derate linearly to zero at 125°C or 155°C depending on size.

## Tests and Requirements
Includes:
- TCR
- Life/endurance
- High-temperature exposure
- Moisture resistance
- Humidity
- Thermal shock
- Short-time overload
- Board flex/bending
- Solderability
- Leaching
- Resistance to soldering heat
