sabinM1/VL53L8CX-carrier/reference docs/components/Yageo_RE_Precision_Resistors.md

# Yageo RE Series — Precision-Grade Thick-Film Chip Resistors

Source file: `pyu-re_105_rohs_l.pdf`

## Scope
RE0201 to RE1206 ultra-precision chip resistors with lead-free terminations, thick-film process.

## Applications
- Converters
- Printer equipment
- Server boards
- Telecom
- Consumer

## Features
- Halogen-free epoxy
- RoHS compliant
- High component and equipment reliability
- Non-forbidden materials
- MSL 1

## Ordering Information — Global Part Number
Format:
`RE XXXX X X XXXX L`

| Field | Meaning |
|---|---|
| (1) Size | 0201/0402/0603/0805/1206 |
| (2) Tolerance | B=±0.1%, D=±0.5%, F=±1% |
| (3) Packaging | R = paper/PE taping reel |
| (4) TCR | E = ±50 ppm/°C |
| (5) Reel | 07=7-in, 10=10-in, 13=13-in |
| (6) Resistance | 2–4 digits; R/K/M = decimal point |
| (7) Default | L |

Example: `RE0603DRE0756RL` = RE0603, ±0.5%, TC50, 56 Ω, 7-in reel.

## Marking
- RE0201/0402: no marking
- RE0603:
  - 1%, 0.5%, 0.1% E24 exception values: 3 digits
  - E96: EIA-96 marking
- RE0805/1206: 4 digits (E24 or E96)

## Construction
High-grade ceramic body, internal metal electrodes, resistive layer, laser trimming, protective coat, matte tin terminations.

## Dimensions

| Type | L (mm) | W (mm) | H (mm) | I1 (mm) | I2 (mm) |
|---|---:|---:|---:|---:|---:|
| RE0201 | 0.60 ± 0.03 | 0.30 ± 0.03 | 0.23 ± 0.03 | 0.10 ± 0.05 | 0.15 ± 0.05 |
| RE0402 | 1.00 ± 0.05 | 0.50 ± 0.05 | 0.32 ± 0.05 | 0.20 ± 0.10 | 0.25 ± 0.10 |
| RE0603 | 1.60 ± 0.10 | 0.80 ± 0.10 | 0.45 ± 0.10 | 0.25 ± 0.15 | 0.25 ± 0.15 |
| RE0805 | 2.00 ± 0.10 | 1.25 ± 0.10 | 0.50 ± 0.10 | 0.35 ± 0.20 | 0.35 ± 0.20 |
| RE1206 | 3.10 ± 0.10 | 1.60 ± 0.10 | 0.55 ± 0.10 | 0.45 ± 0.20 | 0.45 ± 0.20 |

## Electrical Characteristics

| Type | Resistance Range | Operating Temp | Power Rating | Max Working Voltage | Dielectric Withstand | Max Overload | TCR |
|---|---|---:|---:|---:|---:|---:|---|
| RE0201 | 100 Ω–1 MΩ | -55°C to +155°C | 1/20 W | 25 V | 50 V | 50 V | ±50 ppm/°C |
| RE0402 | 10 Ω–1 MΩ | -55°C to +155°C | 1/16 W | 50 V | 100 V | 100 V | ±50 ppm/°C |
| RE0603 | 10 Ω–1 MΩ | -55°C to +155°C | 1/10 W | 75 V | 150 V | 150 V | ±50 ppm/°C |
| RE0805 | 10 Ω–1 MΩ | -55°C to +155°C | 1/8 W | 150 V | 300 V | 300 V | ±50 ppm/°C |
| RE1206 | 10 Ω–1 MΩ | -55°C to +155°C | 1/4 W | 200 V | 500 V | 400 V | ±50 ppm/°C |

## Rated Voltage
\[
V=\sqrt{P\times R}
\]
or maximum working voltage, whichever is less.

## Packing Style and Quantity

| Size | 7-in | 10-in | 13-in |
|---|---:|---:|---:|
| RE0201 | 10,000 | 20,000 | 50,000 |
| RE0402 | 10,000 | 20,000 | 50,000 |
| RE0603 | 5,000 | 10,000 | 20,000 |
| RE0805 | 5,000 | 10,000 | 20,000 |
| RE1206 | 5,000 | 10,000 | 20,000 |

## Tests and Requirements
Includes:
- Life/endurance
- High-temperature exposure
- Moisture resistance
- Thermal shock
- Short-time overload
- Board flex/bending
- Humidity
- Solderability
- Leaching
- Resistance to soldering heat
