sabinM1/VL53L8CX-carrier/reference docs/components/Yageo_X5R_MLCC_Capacitors.md

# Yageo X5R MLCC — Surface Mount Multilayer Ceramic Capacitors, 4 V to 50 V

Source file: `upy-gphc_x5r_4v-to-50v.pdf`

## Scope
X5R series chip capacitors with lead-free terminations.

## Applications
- PCs, hard disk, game PCs
- Power supplies
- DVD players
- Mobile phones
- Data processing

## Features
- Supplied in tape on reel
- Nickel-barrier end termination
- RoHS compliant
- Halogen free

## Ordering Information — Global Part Number
Format:
`CC XXXX X X X5R X BB XXX`

| Field | Meaning |
|---|---|
| (1) Size | 0201 (0603), 0402 (1005), 0603 (1608), 0805 (2012), 1206 (3216), 1210 (3225) |
| (2) Tolerance | K = ±10%, M = ±20% |
| (3) Packing | R = paper/PE 7-in reel; K = blister 7-in; P = paper/PE 13-in; F = blister 13-in; C = bulk |
| (4) Rated voltage | 4 = 4 V; 5 = 6.3 V; 6 = 10 V; 7 = 16 V; 8 = 25 V; 9 = 50 V |
| (5) Capacitance | 2 significant digits + zeros; R = decimal point; e.g. 103 = 10 nF |

## Construction
Rectangular ceramic dielectric block with interleaved metal electrodes; inner electrodes connected to end terminations; plated tin (NiSn); lead-free.

## Dimensions

| Type | L1 (mm) | W (mm) | T (mm) | L2/L3 (mm) | L4 min (mm) | Code |
|---|---|---|---:|---:|---:|---|
| 0201 | 0.6 ± 0.03 | 0.3 ± 0.03 | 0.3 ± 0.03 | 0.10–0.20 | 0.2 | BA |
| 0201 | 0.6 ± 0.05 | 0.3 ± 0.05 | 0.3 ± 0.05 | 0.10–0.20 | 0.2 | BB |
| 0201 | 0.6 ± 0.09 | 0.3 ± 0.09 | 0.3 ± 0.09 | 0.10–0.25 | 0.2 | BC |
| 0201 | 0.6 ± 0.15 | 0.3 ± 0.15 | 0.3 ± 0.15 | 0.10–0.25 | 0.2 | BD |
| 0402 | 1.0 ± 0.05 | 0.5 ± 0.05 | 0.5 ± 0.05 | 0.15–0.35 | 0.3 | CA |
| 0402 | 1.0 ± 0.10 | 0.5 ± 0.10 | 0.5 ± 0.10 | 0.15–0.35 | 0.3 | CB |
| 0402 | 1.0 ± 0.15 | 0.5 ± 0.15 | 0.5 ± 0.15 | 0.15–0.35 | 0.3 | CC |
| 0402 | 1.0 ± 0.20 | 0.5 ± 0.20 | 0.5 ± 0.20 | 0.15–0.35 | 0.3 | CD |
| 0603 | 1.6 ± 0.10 | 0.8 ± 0.10 | 0.8 ± 0.10 | 0.20–0.60 | 0.4 | DA |
| 0603 | 1.6 ± 0.15 | 0.8 ± 0.15 | 0.8 ± 0.15 | 0.20–0.60 | 0.4 | DB |
| 0603 | 1.6 ± 0.20 | 0.8 ± 0.20 | 0.8 ± 0.20 | 0.20–0.60 | 0.4 | DC |
| 0805 | 2.0 ± 0.20 | 1.25 ± 0.20 | 0.85 ± 0.10 | 0.25–0.75 | 0.7 | EA |
| 0805 | 2.0 ± 0.20 | 1.25 ± 0.20 | 1.25 ± 0.20 | 0.25–0.75 | 0.7 | EB |
| 1206 | 3.2 ± 0.20 | 1.6 ± 0.20 | 1.15 ± 0.10 | 0.25–0.75 | 1.4 | FA |
| 1206 | 3.2 ± 0.30 | 1.6 ± 0.20 | 1.25 ± 0.20 | 0.25–0.75 | 1.4 | FB |
| 1206 | 3.2 ± 0.30 | 1.6 ± 0.30 | 1.60 ± 0.20 | 0.25–0.80 | 1.4 | FC |
| 1210 | 3.2 ± 0.30 | 1.6 ± 0.30 | 1.60 ± 0.30 | 0.30–0.90 | 1.4 | FD |
| 1210 | 3.2 ± 0.40 | 2.5 ± 0.30 | 1.25 ± 0.20 | 0.25–0.75 | 1.4 | GA |
| 1210 | 3.2 ± 0.40 | 2.5 ± 0.30 | 1.90 ± 0.20 | 0.25–0.75 | 1.4 | GB |
| 1210 | 3.2 ± 0.40 | 2.5 ± 0.30 | 2.5 ± 0.20 | 0.25–0.75 | 1.0 | GC |
| 1210 | 3.2 ± 0.40 | 2.5 ± 0.30 | 2.5 ± 0.30 | 0.25–0.75 | 1.0 | GD |

## Capacitance Range & Thickness (X5R, Representative)
Capacitance range includes 22 nF to 220 µF depending on size and voltage. Thickness classes are indicated by codes BA/CA/.../GD. Non-E6 values available on request.

## Electrical Characteristics (X5R)
- Capacitance tolerance: ±10%, ±20%
- Dissipation factor: depends on voltage/capacitance; typically ≤5%, ≤7%, ≤10%, ≤15%, ≤20%
- Insulation resistance: \(R_{ins}\ge 10\ GΩ\) or \(R_{ins}\times C_r\ge 50/100/500\) s, whichever is less
- Temperature characteristic: \(\Delta C/C \le \pm 15\%\) over -55°C to +85°C

## Tests and Requirements
Includes:
- Visual inspection and dimension check
- Capacitance and dissipation factor
- Insulation resistance
- Adhesion and bending strength
- Resistance to soldering heat
- Solderability
- Rapid change of temperature
- Voltage proof
- Endurance
- Temperature cycling
- Mechanical shock and vibration
- Board flex
