sabinM1/VL53L8CX-carrier/pcb design/BOM.csv

Reference | Assembly | Qty | Value | MPN | Package | Purpose | Notes
U1 | Carrier | 5 | VL53L8CX | VL53L8CXV0GC/1 | LGA-16 6.4x3.0x1.75 mm | 8x8 multizone ToF sensor | SOURCED (liner version); SPI mode; MSL 3; no wet cleaning or coating; max 3 reflows; REMOVE THE LINER after reflow and before the cover glass
U2 | Carrier | 5 | MIC5504-1.8 | MIC5504-1.8YMT-TR | UDFN-4 1.0x1.0 mm (MT) | 1.8 V LDO for CORE_1V8 + IOVDD + VCCA | CONFIRMED datasheet; UDFN pinout 1=VOUT 2=GND 3=EN 4=VIN + EP to GND; EN high >= 1.2 V; 4 Mohm EN pull-down; 25 ohm auto-discharge; +/-3 % over temperature; EN tied to VIN (tracks 3V3_SW)
U3 | Carrier | 5 | SN74AXC4T774 | SN74AXC4T774RSVR | UQFN-16 2.6x1.8 mm (RSV) | SCLK/MOSI/MISO 3.3 V <-> 1.8 V translator | OE = NCS_S; DIR1/2/3 = GND; DIR4 = 1V8; DIR and OE are VCCA-referenced; VCCB = 3V3_SW; pinout confirmed (VCCA 14 VCCB 13 GND 8 OE 7 A1-A4 1-4 B1-B4 12/11/10/9 DIR1/2 15/16 DIR3/4 5/6)
U5 | Carrier | 5 | SN74AXC1T45 | SN74AXC1T45DTQR | X2SON-6 1.0x0.8 mm | NCS translator 3.3 V -> 1.8 V | CONFIRMED datasheet; pins 1=VCCA 2=GND 3=A 4=B 5=DIR 6=VCCB; DIR = GND => B->A; VCCB = 3V3_SW; DTQR is the sourced part (DCK/DBV are same-die alternatives only)
U10 | Carrier | 5 | Load switch (NOT a regulator) | TPS22918TDBVRQ1 | SOT-23-6 (DBV) | Per-carrier switched 3.3 V rail: 3V3_IN -> 3V3_SW | AEC-Q100 SOURCED; pins 1 VIN 2 GND 3 ON 4 CT 5 QOD 6 VOUT; it PASSES VIN to VOUT and creates no voltage of its own; CT OPEN with no footprint => t_R 95 us at 3.3 V; STRAP QOD (5) TO VOUT (6) for the internal 25 ohm discharge; ON has NO internal pull-down; R_ON 53 mohm typ => ~5 mV at 93 mA; VIN max 5.5 V
C1 | Carrier | 5 | 4.7 uF X5R 10 V | C1005X5R1A475K050BC | 0402 (C1005) | AVDD decoupling at U1.C4 | CONFIRMED 4.7 uF 10 V X5R +/-10 %; on the 3V3_SW net; check DC-bias derating at 3.3 V; raise to 0603 if residual < ~2 uF
C2 | Carrier | 5 | 100 nF | CC0402KRX5R6BB104 | 0402 | CORE_1V8 decoupling at U1.B7 | 100 nF 10 V X5R +/-10%; K tolerance per Yageo ordering table (6 = 10 V); verify reel at order
C3 | Carrier | 5 | 100 nF | CC0402KRX5R6BB104 | 0402 | IOVDD decoupling at U1.A3 | Within 3 mm of pin; 10 V X5R +/-10%
C4 | Carrier | 5 | 100 nF | CC0402KRX5R6BB104 | 0402 | U3 VCCA decoupling | Within 3 mm of U3; 10 V X5R +/-10%
C5 | Carrier | 5 | 100 nF | CC0402KRX5R6BB104 | 0402 | U3 VCCB decoupling | Within 3 mm of U3; 10 V X5R +/-10%
C6 | Carrier | 5 | 2.2 uF X5R 10 V | C1005X5R1A225K050BC | 0402 (C1005) | U2 input decoupling | CONFIRMED 2.2 uF 10 V X5R +/-10 %; on the 3V3_SW net; must stay >= 1 uF at 3.3 V DC bias
C7 | Carrier | 5 | 1 uF X5R 10 V | MCASL105SB5105KFNA01 | 0402 | U2 output decoupling | CONFIRMED Taiyo Yuden MCAS 1 uF 10 V (L) X5R (B5) +/-10 % (K); confirm case size and thickness on product page
C8 | Carrier | 5 | 100 nF | CC0402KRX5R6BB104 | 0402 | U5 VCCA decoupling | Within 3 mm of U5; 10 V X5R +/-10%
C9 | Carrier | 5 | 100 nF | CC0402KRX5R6BB104 | 0402 | U5 VCCB decoupling | Within 3 mm of U5; 10 V X5R +/-10%
C10 | Carrier | 5 | 4.7 uF X5R 10 V | C1005X5R1A475K050BC | 0402 (C1005) | U10 input reservoir on 3V3_IN | Reuses the C1 part; TPS22918 requires CIN >= 1 uF; place within 3 mm of U10.1; this is the per-board local reservoir that replaces the former single 22 uF
R1 | Carrier | 5 | 47 kohm | RC0402DR-0747KL | 0402 | NCS_S pull-up to 1V8 | CONFIRMED Yageo RC 47 kohm +/-0.5 % 7-in reel; holds NCS_S high while U5 is indeterminate
R2 | Carrier | 5 | 47 kohm | RC0402DR-0747KL | 0402 | INT pull-up to 1V8 | INT not routed to host
R3 | Carrier | 5 | 47 kohm | RC0402DR-0747KL | 0402 | SYNC pull-up to 1V8 | Do not tie SYNC across boards
R4 | Carrier | 5 | 47 kohm | RC0402DR-0747KL | 0402 | LPn pull-up to 1V8 | Device always enabled
R5 | Carrier | 5 | 47 kohm | RC0402DR-0747KL | 0402 | SPI_I2C_N pull-up to 1V8 | Selects SPI mode
R6 | Carrier | 5 | 6.8 kohm | AC0402FR-076K8L | 0402 | SCLK_S pull-up to 1V8 | SOURCED Yageo AC 6.8 kohm +/-1 % (F); replaces the 10 kohm part AC0402DR-0710KL; 1.64 V idle vs V_IH 1.26 V; within TI's <= 7 kohm limit
R7 | Carrier | 5 | 4.7 kohm | RE0402DRE074K7L | 0402 | NCS_H pull-up to 3V3_SW | CONFIRMED Yageo RE 4.7 kohm +/-0.5 % 50 ppm; reference the SWITCHED rail and not 3V3_IN; keep board-side
J1 | Carrier | 5 | 2x4 header 2.54 mm | PH2-08-UA (Adam Tech) | THT 2x4 2.54 mm | Carrier interface | SOURCED; dual-row PH2 series (same vendor family as the previous PH1); STRAIGHT/vertical; 8 positions on 2.54 mm pitch and 2.54 mm row spacing; 3 A per contact; gold plating; square brass pins; no moulded pin-1 mark so silkscreen it; pinout 1 3V3_IN / 2 GND / 3 GND / 4 SCLK / 5 MOSI / 6 MISO / 7 NCS / 8 RAIL_EN
PCB | Carrier | 5 | VL53L8CX carrier PCB | - | 2-layer FR4 1.6 mm 1 oz | Sensor carrier | ENIG preferred; copy DS14161 land pattern and AN5897 thermal pad
DC1 | System | 1 | 3S LiPo to 3.3 V buck | Pololu #5266 (APM81815 3.3 V carrier) | 10.2 x 19.1 x 3.2 mm module | THE ACTUAL 3.3 V SOURCE for the whole array | SOURCED; 5-72 V in (3S = 9.0-12.6 V); 1.1 A at 48 V in and MORE at 3S; 2 % output accuracy; soft-start; EN pin with precision threshold (usable as a 3S low-voltage cutoff with a 2-resistor divider); approx 1 g; approx USD 7; NO reverse-voltage protection
R10 | System | 1 | 100 kohm | RC0402DR-07100KL | 0402 | RAIL_EN pull-down to GND at the host | ONE resistor for all five carriers; makes the rail default OFF at every Teensy reset; TPS22918 has no internal pull-down
CB1 | System | 1 | >= 47 uF (>= 25 V) | TO SOURCE | 1206 or radial | LC-spike suppression at the DC1 INPUT | 3S is 12.6 V max so use >= 25 V; place close to DC1 VIN per the Pololu datasheet note; this is on the battery side and not the 3.3 V side
T4 | System | 1 | Teensy 4.0 | TEENSY40 | - | Host | Powered from USB only; its 3.3 V pin NEVER feeds the array; supplies only RAIL_EN on pin 2
ST1 | System | 1 | Stencil 90-150 um | from PCB fab | - | Assembly tool | Do not merge the thermal-pad apertures into one opening
