sabinM1/VL53L8CX-carrier/pcb design/Schematic_and_PCB_Guide.md

# Schematic and PCB design guide — VL53L8CX carrier

How to turn the frozen design in `../Design_proposal.txt` (Rev 9) into a
schematic and a fabricated board. Read `../README.md` first for the system
overview.

This is a **two-layer, 22-part carrier** repeated five times. There is **no
separate power board**: each carrier carries its own 3.3 V load switch (U10),
and the only external power part is a 3S→3.3 V buck module (DC1). Nothing here
is high speed: 3 MHz SPI, 150 mA per LDO.

**Document precedence.** Where this guide and a primary document disagree, the
primary document wins:

1. `DS14161_VL53L8CX_Datasheet.pdf` — sensor electrical, pin, land-pattern and reflow data.
2. `AN5897_VL53L8_Thermal_Guidelines.pdf` — thermal pad, via and paste pattern.
3. `VL53L8_PCB_Manufacturing_Guidelines.pdf` — assembly, MSL3, rework.
4. `../Design_proposal.txt` — this project's frozen decisions.
5. This guide — procedure and checklists.

---

## 0. Design inputs (do not redesign these)

| Item | Value | Source |
|---|---|---|
| Sensor interface | SPI mode 3, 3 MHz | DS14161 Table 8 |
| Sensor supplies | AVDD 3.3 V, CORE_1V8/IOVDD 1.8 V | DS14161 Table 9/10 |
| 1.8 V absolute max | 1.98 V | DS14161 |
| AVDD window | 3.13–3.47 V recommended | DS14161 |
| CORE_1V8 slew | 0.9 → 1.6 V in **≤ 58.3 µs** (minimum 0.012 V/µs) | DS14161 Table 5 |
| AVDD slew | full level in ≤ 3.3 ms (minimum 0.001 V/µs) | DS14161 Table 5 |
| SPI sink/source | V_OL ≤ 0.2 × IOVDD at 4 mA; V_IH ≥ 0.7 × IOVDD | DS14161 Table 15 |
| Header | J1 2×4: 3V3_IN, GND, GND, SCLK, MOSI, MISO, NCS, RAIL_EN | Design |
| Address/straps | SPI_I2C_N, LPn pulled to IOVDD | Design |
| Reset | **None on the sensor.** U10 on the carrier is the reset (kills AVDD and 1V8 together) | Design |
| Board count | 5 identical carriers | Design |

Carrier part count: **22 SMD parts** (5 ICs, 7 resistors, 10 capacitors) + J1.
Do not add parts without a review entry in `Design_proposal.txt`.

### 0.1 Power tree (Rev 9)

```
3S LiPo -> CB1 (>= 47 uF) -> DC1 buck -> 3V3_IN on all five J1-1
                                              |
                        per carrier: C10 (4.7 uF) -> U10 (TPS22918) -> 3V3_SW
                                              |
              3V3_SW -> U1 AVDD, U2 VIN, U3 VCCB, U5 VCCB, R7
                         U2 -> 1V8 -> CORE_1V8, IOVDD, VCCA
```

`3V3_IN` and `3V3_SW` are **two different nets on every carrier**, joined only
through U10. Never short them.

---

## 1. Sheet plan

Use two schematic sheets (or two clearly separated areas on one sheet):

| Sheet | Contents |
|---|---|
| 1 — Carrier (root) | U1 sensor, U2 LDO, U3/U5 translators, U10 load switch, all passives, J1. This sheet is copied ×5 |
| 2 — Host interface | Teensy 4.0 pin map, RAIL_EN resistor R10, notes block for DC1/CB1. Only draw it if you draw the harness |

Keep the carrier sheet **identical** across the five instances. Use a
hierarchical sheet or a replicated block so a change cannot be applied to only
one board.

---

## 2. Net list to capture (per carrier)

Capture exactly these nets. Net names matter — later checks and the firmware
documentation reference them.

### 2.1 Power nets

| Net | Connections |
|---|---|
| `3V3_IN` | J1-1, C10, U10.1 (VIN) |
| `3V3_SW` | U10.6 (VOUT), U10.5 (QOD strap), C1, U1.C4 (AVDD), U2.IN, C6, U3.13 (VCCB), C5, U5.6 (VCCB), C9, R7 |
| `1V8` | U2.OUT, C7, U1.A3 (IOVDD) + C3, U1.B7 (CORE_1V8) + C2, U3.14 (VCCA) + C4, U5.1 (VCCA) + C8, R1, R2, R3, R4, R5, R6 |
| `GND` | J1-2, J1-3, U1.C3, U1.C7, U1.B4 (thermal pad), U2.GND, U2.EP, U3.8, U5.2, U10.2, C1–C10 returns |
| `RAIL_EN` | J1-8, U10.3 (ON). No on-board pull-down — R10 is at the host |

`U2.EN` ties to `U2.IN` (`3V3_SW`), so the LDO tracks the switch's edge. There
is **no** per-board enable network.

**`3V3_IN` and `3V3_SW` must not be shorted.** The only connection between them
is U10's channel (pins 1 → 6). `3V3_SW` exists only after U10, so the AVDD and
1.8 V rails collapse together when `RAIL_EN` drops.

### 2.2 Signal nets

| Net | Connections |
|---|---|
| `SCLK_H` | J1-4, U3.12 (B1), R6 is **not** here |
| `MOSI_H` | J1-5, U3.11 (B2) |
| `MISO_H` | J1-6, U3.9 (B4) |
| `NCS_H` | J1-7, U5.4 (B), R7 to `3V3_SW` |
| `SCLK_S` | U3.1 (A1), U1.A5 (SCL/MCLK), **R6 to `1V8`** |
| `MOSI_S` | U3.2 (A2), U1.A4 (SDA/MOSI) |
| `MISO_S` | U3.4 (A4), U1.C5 (MISO) |
| `NCS_S` | U5.3 (A), U1.C2 (NCS), R1 to `1V8`, **U3.7 (OE)** |

`SCLK_S`, `MOSI_S`, `MISO_S` and `NCS_S` are 1.8 V nets. `NCS_S` has **four**
connections — it is both the chip select and the translator enable. That is the
whole scheme; keep it.

### 2.3 Straps and unused pins

| Pin | Net |
|---|---|
| U1.A1 (GPIO1/INT) | R2 47 kΩ to `1V8`; no host connection |
| U1.B1 (GPIO2/SYNC) | R3 47 kΩ to `1V8`; no host connection |
| U1.A2 (LPn) | R4 47 kΩ to `1V8` (device always enabled) |
| U1.C1 (SPI_I2C_N) | R5 47 kΩ to `1V8` (selects SPI) |
| U1.A6, U1.A7, U1.C6 (RSVD1–3) | `GND` — **confirmed** against DS14161 Table 3, which says "connect to ground" |
| U3.3 (A3) | No connect (idle channel) |
| U3.10 (B3) | `GND` (drives the idle A3 low) |
| U3.15, U3.16 (DIR1, DIR2) | `GND` (B→A) |
| U3.5 (DIR3) | `GND` |
| U3.6 (DIR4) | `1V8` (A→B: sensor MISO to host) |
| U5.5 (DIR) | `GND` ⇒ B→A, i.e. NCS_H (3.3 V) drives NCS_S (1.8 V) |

> **Pin-table check (closed).** DS14161 Table 3 gives `RSVD1` (A6), `RSVD2`
> (A7) and `RSVD3` (C6) as "connect to ground". The GND tie in this design is
> correct; the manufacturing guideline's "DNC must be left unconnected" applies
> to pads the datasheet actually marks DNC, and there are none of those here.
> Table 3 also confirms C1 `SPI_I2C_N` is the pin that doubles as the I²C
> interface reset — there is no separate `I2C_RST` pad.

---

## 3. Schematic capture, step by step

### 3.1 Sensor symbol (U1)

1. Use the ST land pattern / symbol with pads A1–A7, B1, B4, B7, C1–C7
   (16 pads). B4 is the **thermal and ground pad**, not a signal.
2. Place the decoupling capacitors so the schematic reflects the layout
   intent: C1 at C4 (AVDD), C3 at A3 (IOVDD), C2 at B7 (CORE_1V8).
3. Do not route INT, SYNC or LPn off-board. They are pull-ups only.
4. Add a text note on the sheet: *"I/O is 1.8 V. Never connect a host pin
   directly. Absolute max on CORE_1V8/IOVDD is 1.98 V."*

### 3.2 LDO (U2, MIC5504-1.8)

1. `IN` = `3V3_SW`, `OUT` = `1V8`, `GND` = `GND`, `EN` = `IN`.
2. C6 (2.2 µF) at IN, C7 (1 µF) at OUT, both within a few mm in layout.
3. UDFN pinout is **1 = VOUT, 2 = GND, 3 = EN, 4 = VIN, exposed pad = GND**
   (confirmed from the Microchip datasheet). The EP is not optional — connect it.
4. Add a note: *"EN tied to IN — the `3V3_SW` edge does the sequencing."*

### 3.3 SPI translator (U3, SN74AXC4T774)

1. VCCA = `1V8` (pin 14), VCCB = `3V3_SW` (pin 13), GND = pin 8.
2. OE = pin 7 = `NCS_S`. Active low: NCS high ⇒ U3 Hi-Z.
3. Channel map (A side is the 1.8 V sensor, B side the 3.3 V host):
   - A1/B1 = SCLK, DIR1 = GND (B→A)
   - A2/B2 = MOSI, DIR2 = GND (B→A)
   - A3/B3 = unused; B3 to GND, A3 no connect, DIR3 = GND
   - A4/B4 = MISO, DIR4 = `1V8` (A→B)
4. C4 (100 nF) at VCCA, C5 (100 nF) at VCCB.
5. **Pin numbers are confirmed** against TI's Figure 4-3 / Table 4-1:
   VCCA 14, VCCB 13, GND 8, OE 7, A1–A4 1–4, B1–B4 12/11/10/9, DIR1/2 15/16,
   DIR3/4 5/6.

> **Do not** route NCS through U3. If NCS is on the A/B pair that U3 gates, the
> board can never be selected because OE is derived from that same NCS.

### 3.4 NCS translator (U5, SN74AXC1T45)

1. VCCA = pin 1 = `1V8`, GND = pin 2, A = pin 3 = `NCS_S`, B = pin 4 = `NCS_H`,
   DIR = pin 5 = `GND`, VCCB = pin 6 = `3V3_SW`.
2. **DIR = GND selects B→A**, so the 3.3 V host side drives the 1.8 V sensor
   side. This is the required direction, and the arrow in older text that said
   "A→B" was wrong.
3. C8 (100 nF) at VCCA, C9 (100 nF) at VCCB.
4. Pin numbers and direction are **confirmed** from the TI datasheet (residual R5
   is closed). The sourced part is **SN74AXC1T45DTQR** (X2SON-6, 1.0 × 0.8 mm).
   DCK (SC70-6) and DBV (SOT-23-6) are the same die in easier packages if you
   rework by hand, but the BOM and the footprint use DTQR.

### 3.5 Passives

| Ref | Value | From | To | Placement intent |
|---|---|---|---|---|
| R1 | 47 kΩ | `NCS_S` | `1V8` | Holds NCS_S high while U5 is indeterminate |
| R2 | 47 kΩ | `U1.A1` | `1V8` | INT unused |
| R3 | 47 kΩ | `U1.B1` | `1V8` | SYNC unused (per-acquisition trigger; do not tie boards together) |
| R4 | 47 kΩ | `U1.A2` | `1V8` | LPn high = enabled |
| R5 | 47 kΩ | `U1.C1` | `1V8` | SPI mode |
| R6 | 6.8 kΩ | `SCLK_S` | `1V8` | Holds mode-3 idle level so selecting the board cannot clock a bit |
| R7 | 4.7 kΩ | `NCS_H` | `3V3_SW` | Keeps the board deselected, and references the **switched** rail so it never back-feeds a dead node from the host's perspective |

R6 and R7 are engineering additions, not datasheet requirements. Do not
increase R6 above 7 kΩ (TI's external pull-up limit against the 71 kΩ internal
pull-down) and do not move R7 to the host.

### 3.6 Header (J1)

1. **2×4, 2.54 mm, THT, straight/vertical** — Adam Tech `PH2-08-UA`, the
   dual-row member of the same PH series as the previously sourced `PH1-06-UA`:
   8 positions, 2 rows, 2.54 mm pitch **and** 2.54 mm row spacing, square brass
   pins, gold plating, **3 A per contact**, −55…+105 °C.
2. Footprint: 1.02 mm holes on 2.54 mm pitch in both directions; **7.62 mm**
   between the two end pins (vs 15.24 mm for the 1×7), row spacing 2.54 mm,
   body ≈ 5.08 mm wide. **Straight, not right-angle.** The 2×4 pattern is about
   7.6 mm shorter than the 1×7, which is what allows the board outline to shrink.
3. Pin order (odd pins on row A, even pins on row B):

| Pin | Net |
|---|---|
| 1 | `3V3_IN` |
| 2 | `GND` |
| 3 | `GND` (second return; a full duplicate of pin 2) |
| 4 | `SCLK` |
| 5 | `MOSI` |
| 6 | `MISO` |
| 7 | `NCS` |
| 8 | `RAIL_EN` |

4. Pins 1 and 2 sit **directly across from each other** so the supply and its
   return form the smallest possible loop; pin 3 halves the harness return
   resistance and puts a ground next to the signals.
5. **Silkscreen pin 1 and all eight net names.** The header has no moulded
   pin-1 mark, and a 2×4 outline has 180° rotational symmetry — the only
   protection against a reversed plug is the board silkscreen plus a
   **keyed/polarised socket** (an 8-way 2×4 IDC ribbon socket is the natural
   harness choice) or a shrouded box header.

### 3.7 Load switch (on every carrier)

1. `J1-1 (3V3_IN)` → **C10 4.7 µF to GND** → **U10 pin 1 (VIN)** →
   **U10 pin 6 (VOUT)** = `3V3_SW` → C1, U1.C4, U2.IN, C6, U3.13, U5.6, R7.
   There is no C11: C1 and C6 are the output capacitance.
2. U10 = **TPS22918TDBVRQ1**, SOT-23-6 (DBV), 2 A. Wire every pin:

| Pin | Name | Net | Connection |
|---|---|---|---|
| 1 | VIN | `3V3_IN` | At J1-1, with C10 4.7 µF to GND within 3 mm |
| 2 | GND | `GND` | Via to the ground pour |
| 3 | ON | `RAIL_EN` | J1-8. **No on-board pull-down** — R10 is at the host, one for all five |
| 4 | CT | — | **No connection, no footprint** |
| 5 | QOD | `3V3_SW` | **Strap directly to pin 6**, no external resistor |
| 6 | VOUT | `3V3_SW` | Feeds the whole carrier |

3. **CT stays open permanently.** 275 µs is an upper bound on the rail edge and
   CT only slows it further; if the CORE_1V8 window fails, CT cannot fix it.
   Do not fit a capacitor, do not lay out the pad.
4. **QOD is strapped, not optional.** Direct tie enables the internal 25 Ω at
   3.3 V: ~7.1 µF of `3V3_SW` capacitance discharges with τ ≈ 0.2 ms. With the
   pin open, QOD is disabled and the power-cycle recovery silently stops
   working.
5. `RAIL_EN` must be pulled low by **R10 100 kΩ at the host** (J1-8 → GND).
   ON leakage ≤ 0.1 µA gives 10 mV across 100 kΩ, far below V_IL = 0.5 V, so the
   rail is **off** whenever the host is off, resetting, or before firmware runs.
6. **Ordering rule:** assert `RAIL_EN` before driving any CS line. With
   `3V3_SW` dead, a driven NCS_H sinks ~0.7 mA per board through R7 into the
   dead node. Firmware already does this (`RAIL_EN_PIN` is the first statement
   of `setup()`).
7. U10 is the only sensor reset, and because it sits on the carrier it kills
   AVDD and CORE_1V8 **together**, which DS14161 requires. A per-board EN
   pull-down does not (AVDD stays up).
8. Star ground: one point at the host; five separate ground wires to the
   carriers; Teensy GND joins only at that point. Never join the Teensy 3.3 V
   pin to `3V3_IN`.
9. Off-board power: `DC1` (Pololu #5266, 3.3 V buck) → `3V3_IN`; `CB1` ≥ 47 µF
   ≥ 25 V at the **DC1 input** (battery side). DC1 is 2 % accurate, so
   `3V3_IN` ≈ 3.234–3.366 V; the 5 mV switch drop and the harness resistance
   keep the far-board AVDD above 3.13 V. Do not add bulk downstream of a
   switch — it only raises that switch's inrush.

---

## 4. Schematic review (ERC and human checks)

Run ERC, then check each row by hand. Every row must pass before layout.

| # | Check | Pass criterion |
|---|---|---|
| S1 | `3V3_SW` reaches sensor AVDD, both translator VCCBs and the LDO input | One net, no series part |
| S2 | `1V8` reaches sensor IOVDD + CORE_1V8, both translator VCCAs, all pull-ups | One net |
| S3 | No 3.3 V net touches any sensor pin except through U3/U5 | Zero exceptions |
| S4 | U3.OE = `NCS_S` (not VCC, not GND) | Exactly one connection, to `NCS_S` |
| S5 | U5 DIR = GND, U5 B = `NCS_H`, U5 A = `NCS_S` | Matches the direction table |
| S6 | U3 DIR4 = `1V8`, DIR1/2/3 = GND | — |
| S7 | U3 B3 = GND, A3 = NC | — |
| S8 | R1–R5 = 47 kΩ to `1V8`; R6 = 6.8 kΩ; R7 = 4.7 kΩ to `3V3_SW` | Values, not just references |
| S9 | Every IC has a 100 nF within a few mm in the placement plan | C1–C10 all used, none orphaned |
| S10 | `3V3_IN` and `3V3_SW` are **separate nets**, joined only by U10 | No short, no 0 Ω, no net tie |
| S11 | DNC/RSVD pins match DS14161 Table 3 | Documented decision, not a guess |
| S12 | Pin numbers match TI's pinout figures | **Pass** — U3 and U5 both confirmed |
| S13 | LDO EN = IN, no per-board enable network | No 2N7002, no RC |
| S14 | No reset line to the sensor | Only U10 |
| S15 | No part added or removed vs the 22-part BOM | Count = 22 |
| S16 | J1 is the 2×4 map: 1 `3V3_IN`, 2 `GND`, 3 `GND`, 4 `SCLK`, 5 `MOSI`, 6 `MISO`, 7 `NCS`, 8 `RAIL_EN`; pins 2 and 3 both on the `GND` net | Eight pins, two of them ground, no signal swapped |

---

## 5. Board mechanical and stackup

There is no frozen outline. Choose one and record it, then reuse it for all five.

Suggested starting point for a hand-solderable, single-sensor carrier:

- Outline ≈ 24–28 mm × 12–15 mm, 1.6 mm FR4, 2 layers, 1 oz copper
  (≈2 mm longer than before to fit U10 and C10; the 2×4 header buys back
  ≈5 mm of that length versus the former 1×7).
- Sensor U1 at one end, optical axis clear of every other part and of the board
  edge (the 45°×45° FoV plus the collector exclusion cone must not see the
  carrier, the harness, or the next board).
- J1 on the opposite edge, pointing away from the sensor. Reserve the 2×4 pad
  field (2 × 2.54 mm row spacing) plus ≈2 mm of clearance on the pin-1 side for
  the silk marker.
- U10 and C10 on the J1 side, next to pin 1 (the 3.3 V entry).
- U3 and U5 adjacent to each other, both close to U1.
- LDO on the J1 side, in copper.
- Two M2 mounting holes, or a 3D-printed frame — the optical axis must be
  repeatable across the five boards.
- Fiducials: two global ones for the panel if you stencil-assemble.

Surface finish: **ENIG preferred** for the LGA land flatness; HASL works but
gives a less planar land. Minimum trace 0.15 mm, via 0.3 mm drill / 0.6 mm pad.

---

## 6. Sensor land pattern and thermal pad (the critical part)

This is where the board is most likely to fail. Follow the primary documents,
not intuition.

1. **Use ST's land pattern** from DS14161 (recommended solder pattern figure)
   for the 14 signal pads. Do not invent or scale it.
2. **NSMD pads** (solder-mask defined, i.e. mask opening larger than the copper
   land). The manufacturing guideline explicitly recommends opening the mask
   external to the land.
3. **Symmetric design.** Keep copper distribution and paste area symmetric around
   the sensor so it self-centres and does not tilt during reflow.
4. **Keep-out below the footprint for signals.** No signal vias or traces under
   the sensor body.
5. **Thermal pad B4:** do not use one large paste aperture. Per AN5897 Fig. 3,
   split the thermal pad paste into **eight rectangles** around a central group
   of vias to GND (8 vias, 0.3 mm class, plugged or tented from the bottom).
   This is both a thermal and a paste-volume control measure.
6. **Stencil 90–150 µm**, uniform paste thickness, SPI-controlled if the
   assembler can. Paste must be flat and even; rough blobs on the LGA land cause
   tilted or open joints.
7. **No wet cleaning and no conformal coating** after assembly. If you must
   coat, mask the optical windows with a gasket/cap.

> The "no vias under the footprint" rule and "vias in the thermal pad" are not
> in conflict: the keep-out applies to signal routing, the thermal vias are the
> deliberate exception inside B4.

---

## 7. Placement

Order of priority:

1. **U1** at its mechanical/optical position (fixed by the enclosure or frame).
2. **C1, C2, C3** — AVDD, CORE_1V8, IOVDD — within 2–3 mm of their pins, on the
   same side as the sensor if possible.
3. **U3** close to U1 (the 1.8 V SPI nets are the short ones), **U5** beside U3
   so `NCS_S` is a few millimetres.
4. **U2** with C6/C7, in copper, away from the sensor's optical axis.
5. **U10** beside J1 pin 1 with **C10 within 3 mm of U10.1** — this is the 3.3 V
   entry point, so keep the J1-1 → C10 → U10.1 loop as small as possible.
6. **R1–R7** near the pin they bias; R6 at `SCLK_S`, R7 at `NCS_H`.
7. **J1** at the edge, pin 1 marked.

Thermal: the LDO dissipates ≈135 mW at full load. Give U2 a copper pour on both
layers connected by vias; this is the only deliberately warm part.

---

## 8. Routing rules

| Net | Rule |
|---|---|
| `SCLK_H`, `MOSI_H`, `MISO_H` | Route as a group, short and direct. Keep `SCLK_H` away from `MISO_H` (no long parallel run). 3 MHz makes impedance control unnecessary |
| `MISO_H` | One driver at a time (guaranteed by OE = NCS_S). Keep the trace off other switching nets |
| `NCS_H` | Direct from J1 to U5; R7 at the U5 end |
| `NCS_S` | **Shortest 1.8 V net on the board.** It drives U3's OE and the sensor's NCS. Keep it away from `SCLK_S` |
| `SCLK_S` | Short; R6 at the sensor end or at U3 A1 |
| `MOSI_S`, `MISO_S` | Short, direct |
| `3V3_IN` | **Short and wide**: J1-1 → C10 → U10.1. This net carries the whole board current, so make it a fat trace or a small pour |
| `3V3_SW` | ≥ 0.5 mm where possible, or a small pour; from U10.6 out to C1, U2, U3.13, U5.6, R7. Keep it out of the U10.1 → C10 loop |
| `1V8` | Pour or ≥ 0.4 mm; C7 at the LDO, C2/C3 at the sensor |
| `GND` | Continuous ground pour on the bottom layer, stitched to top around the sensor, the LDO and U10. J1 pins 2 and 3 land in the pour separately |

Two-layer stackup: signal + components on top, solid ground on the bottom. Do
not split the ground under the sensor. Do not route the 1.8 V rail as a long
thin trace across the board.

Optional: 22 Ω series resistors at the **host** end of SCLK and MOSI, one set
only, if scoping shows ringing. Do not fit them pre-emptively.

---

## 9. Fabrication outputs

- Gerbers: 2 layers, 1.6 mm, 1 oz, ENIG preferred.
- BOM: `BOM.csv` in this folder — one file, carrier and system rows, DNP options
  at Qty 0. Send the carrier rows to the assembler, not the whole file.
- Drill file with the 0.3 mm thermal vias called out (plugged or tented).
- **Stencil**: 90–150 µm, with the thermal-pad apertures split into the eight
  rectangles; do not let the stencil house merge them into one opening.
- Assembly drawing: mark U1 pin 1 and the B4 thermal pad, mark **J1 pin 1**
  (the header has no moulded mark **and a 2×4 can be plugged in 180° rotated**),
  and print the cleaning and coating prohibition plus the **sensor-liner removal
  step (after reflow, before the cover glass)** on it.
- Panelize the five carriers **identically oriented** so the optical axis and
  connector side match after separation. Add fiducials to the panel.
- Provide the assembler with: MSL3 handling note, reflow limits, no-wash /
  no-coat instruction, and the sensor rework limits.

---

## 10. Assembly and reflow

| Item | Requirement |
|---|---|
| MSL | Level 3. Use within 18 months. Store 16–27 °C, 40–60 % RH |
| Baking | If the humidity indicator card is > 10 %: bake 90 °C for > 6 h (sensor only; never bake the tape-and-reel at 90 °C) |
| Reflow | 240 °C recommended, 260 °C maximum, **3 passes max**, convection only, not vapour phase |
| Stencil | 90–150 µm, uniform paste |
| Cleaning | **No wet cleaning** of the sensor |
| Liner (V0GC/1 variant) | Reflow-compatible to 260 °C; **remove after reflow, before the cover glass.** A sensor with the liner left on reads nothing |
| Coating | **Not recommended.** If required, mask the optical windows with a gasket/cap |
| Environment | Class 1000 recommended if using the non-liner sensor variant |
| Rework: desolder | ≤ 275 °C on the cap, < 60 s, protective cube |
| Rework: resolder | ≤ 260 °C (set the station to 250 °C), stencil fixture |
| Fourth reflow | Not guaranteed — replace the sensor and recalibrate |

Do not use hot air without a protective cube around the sensor for nearby
rework. Do not exceed 260 °C on the cap under any circumstance.

---

## 11. Optical integration

- FoV is **45°×45°** (65° diagonal), 940 nm. The collector exclusion cone is
  larger (≈57.6°×57.6°), so the mechanical keep-out is bigger than the FoV.
- If a cover glass or window is used: keep total air gap + glass **< 1.5 mm**;
  no gasket needed below 0.5 mm air gap; a gasket is required above 0.7 mm.
  Crosstalk target ≤ 300 kcps/SPAD.
- The aperture calculator in `../reference docs/Multizone_Cover_Window_Aperture_Calculator.md`
  gives a starting single-rectangle aperture (6.60 × 2.47 mm, offset 0.07 mm in Y)
  for this sensor family — verify against your window geometry.
- **Any cover glass requires crosstalk calibration in firmware**
  (`calibrate_xtalk` / `set_caldata_xtalk`) with a target ≥ 600 mm.
- Keep adjacent sensors' fields of view from overlapping. Five emitters at 940 nm
  with no shared SYNC line are not characterised for mutual interference. SYNC
  is a per-acquisition trigger; never tie all five SYNC pins together.
- Laser class 1: invisible radiation. Do not stare into the emitter; do not
  magnify it with optics.

---

## 12. Layout review checklist (before ordering)

| # | Check | Pass criterion |
|---|---|---|
| L1 | Land pattern matches DS14161 | Copied, not redrawn |
| L2 | Mask openings external to the lands (NSMD) | Visual/DRC |
| L3 | Thermal pad = 8 paste windows + GND vias | Matches AN5897 Fig. 3 |
| L4 | No signal via/trace under the sensor body | DRC keep-out |
| L5 | C1/C2/C3 within 3 mm of their sensor pins | Measured |
| L6 | U3 and U5 within ~5 mm of U1; `NCS_S` < 5 mm | Measured |
| L7 | `SCLK_H` is not a long parallel neighbour of `MISO_H` | Visual |
| L8 | `NCS_S` does not run alongside `SCLK_S` | Visual |
| L9 | Solid GND on the bottom layer, no splits under U1/U3 | Visual |
| L10 | `3V3_IN` and `3V3_SW` copper sized for 150 mA with margin; the J1-1 → C10 → U10.1 loop is short | Visual |
| L11 | U2 and U10 have copper on both layers + vias | Visual |
| L12 | J1 pin 1 and **all eight** pin names on silkscreen | Visual |
| L13 | Optical axis clear of every component and the board edge | Visual + 3D |
| L14 | Stencil layer contains the split thermal apertures | Check the fab output |
| L15 | DRC clean at the fab's minimums; ERC clean | Reports archived |

---

## 13. After fabrication

1. Visual: no paste bridges on the LGA, thermal pad wetted, no tombstoned
   passives.
2. DMM: `3V3_IN`–`GND` not shorted, `3V3_SW`–`GND` not shorted **and not
   shorted to each other**, `1V8`–`GND` not shorted. Power the first board from
   a current-limited supply (100 mA limit) before connecting the Teensy.
3. With the rail on, measure `1V8` = 1.755–1.845 V and AVDD = 3.13–3.47 V.
4. Scope the rail edge and the CORE_1V8 window (pass: ≤ 58.3 µs for 0.9→1.6 V).
   Then drop ON: the rail should fall to < 0.33 V in a few ms (QOD 25 Ω × 36.5 µF
   ⇒ τ ≈ 0.9 ms). If it decays slowly, QOD is not connected.
5. Run `single_sensor_bringup`; a successful start confirms the block size and
   that the trim is accepted.
6. Then follow `../README.md` §8 (bring-up checklist) for the full sequence.

Mode B (3 SPI + 2 I²C) and Mode C (FlexIO) are documented in `../README.md` §3
for reference only. Neither is implemented: there is no I²C carrier variant, no
TCA9406 in the BOM and no Mode B sketch. Build the Mode A carrier only.

---

## 14. Do-not list

- Do not connect the Teensy 3.3 V pin to `3V3_IN`.
- Do not route NCS through U3.
- Do not tie U3.OE to GND or VCC; it must be `NCS_S`.
- Do not fit a pull-down on SCLK_S or any AXC data I/O.
- Do not move R7 to the host side.
- Do not add a per-board EN network or a sensor reset line.
- Do not add bulk capacitance between `3V3_IN` and U10 — it only raises that
  switch's inrush. (C10 4.7 µF at U10.1 is the datasheet C_IN minimum plus the
  local reservoir; that is the only capacitor before the switch.)
- Do not leave the QOD pin open — tie it to VOUT, or there is no discharge path.
- Do not leave the load-switch ON pin floating; it is not internally pulled down.
- Do not use a CT capacitor on the load switch unless the scope says t_R is
  too slow.
- Do not wash or coat the board.
- Do not exceed 260 °C on the sensor cap, or reflow more than three times.
- Do not put vias or traces under the sensor body (thermal-pad vias excepted).
- Do not tie the five SYNC pins together.
- Do not shrink the stencil thermal aperture into one opening.
