sabinM1/VL53L8CX-carrier/reference docs/TN1532_dToF_Assembly_Recommendations.md

# TN1532 — dToF assembly recommendations

**1. Recommendations**
Guidelines for assembling dToF sensors without liners to maintain cleanliness and prevent particle deposition in critical optical areas. 
- Mount in a class 1000 environment.
- Use dry cleaning methods; avoid wet cleaning or coating.

**2. Dust Size Specifications**
Acceptance criteria for Foreign Material (FM) varies by sensor.
*[Image: Figure 1. VL53L0 - Microscope view of the sensor highlighting the two circular emitter/receiver optical areas in red (acceptance criteria 7850 µm²).]*
*[Image: Figure 2. VL53L3 and VL53L4 - Microscope view showing optical glass highlighted in red circles.]*
*[Image: Figure 3. VL53L1 - Microscope view of dual rectangular windows with green bounding boxes indicating the Region of Interest (ROI) and red outer borders.]*
*[Image: Figure 4. VL53L5 - Macro diagram of the sensor defining the green optical areas (9220 µm² criteria), a central purple POOL area (9220 µm²), and outer cap surface (50000 µm²).]*
