sabinM1/VL53L8CX-carrier/code/drivers_libraries/STM32duino_VL53L8CX-2.1.0/src/vl53l8cx_platform.h

/**
 ******************************************************************************
 * @file    vl53l8cx_platform.h
 * @author  STMicroelectronics
 * @version V1.0.0
 * @date    11 November 2021
 * @brief   Header file of the platform dependent structures.
 ******************************************************************************
 * @attention
 *
 * <h2><center>&copy; COPYRIGHT(c) 2021 STMicroelectronics</center></h2>
 *
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
 ******************************************************************************
 */

#ifndef _VL53L8CX_PLATFORM_H_
#define _VL53L8CX_PLATFORM_H_

#ifdef __cplusplus
extern "C" {
#endif


#pragma once

#include <stdint.h>
#include <string.h>
#include "vl53l8cx_platform_config.h"

#ifndef VL53L8CX_COMMS_CHUNK_SIZE
#define VL53L8CX_COMMS_CHUNK_SIZE 4096
#endif
#define SPI_WRITE_MASK(x) (uint16_t)(x | 0x8000)
#define SPI_READ_MASK(x)  (uint16_t)(x & ~0x8000)

typedef uint8_t (*VL53L8CX_wait_Func)(void *, uint32_t);
typedef uint8_t (*VL53L8CX_write_Func)(void *, uint16_t, uint8_t *, uint32_t);
typedef uint8_t (*VL53L8CX_read_Func)(void *, uint16_t, uint8_t *, uint32_t);

#ifndef DEFAULT_I2C_BUFFER_LEN
#ifdef ARDUINO_SAM_DUE
/* FIXME: It seems that an I2C buffer of BUFFER_LENGTH does not work on Arduino DUE. So, we need to decrease the size */
#define DEFAULT_I2C_BUFFER_LEN (BUFFER_LENGTH - 2)
#else
#ifdef BUFFER_LENGTH
#define DEFAULT_I2C_BUFFER_LEN BUFFER_LENGTH
#else
#define DEFAULT_I2C_BUFFER_LEN 32
#endif
#endif
#endif
typedef struct {
  uint16_t  address;
  VL53L8CX_write_Func Write;
  VL53L8CX_read_Func Read;
  VL53L8CX_wait_Func Wait;
  void *handle;
} VL53L8CX_Platform;


uint8_t VL53L8CX_RdByte(
  VL53L8CX_Platform *p_platform,
  uint16_t RegisterAddress,
  uint8_t *p_value);

uint8_t VL53L8CX_WrByte(
  VL53L8CX_Platform *p_platform,
  uint16_t RegisterAddress,
  uint8_t value);

uint8_t VL53L8CX_WrMulti(
  VL53L8CX_Platform *p_platform,
  uint16_t RegisterAddress,
  uint8_t *p_values,
  uint32_t size);

uint8_t VL53L8CX_RdMulti(
  VL53L8CX_Platform *p_platform,
  uint16_t RegisterAddress,
  uint8_t *p_values,
  uint32_t size);

uint8_t VL53L8CX_WaitMs(
  VL53L8CX_Platform *p_platform,
  uint32_t TimeMs);
void VL53L8CX_SwapBuffer(
  uint8_t     *buffer,
  uint16_t     size);

#ifdef __cplusplus
}
#endif

#endif  // _VL53L8CX_PLATFORM_H_
