sabinM1/VL53L8CX-carrier/code/drivers_libraries/STM32duino_VL53L8CX-2.1.0/src/vl53l8cx.h

/**
 ******************************************************************************
 * @file    vl53l8cx.h
 * @author  STMicroelectronics
 * @version V2.0.0
 * @date    27 June 2024
 * @brief   Abstract class of a VL53L8CX Time of Flight(TOF) sensor.
 ******************************************************************************
 * @attention
 *
 * <h2><center>&copy; COPYRIGHT(c) 2024 STMicroelectronics</center></h2>
 *
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
 ******************************************************************************
 */

/* Prevent recursive inclusion -----------------------------------------------*/
#ifndef __VL53L8CX_H
#define __VL53L8CX_H

/* Includes ------------------------------------------------------------------*/
#include "Arduino.h"
#include "Wire.h"
#include "SPI.h"
#include "vl53l8cx_platform.h"
#include "vl53l8cx_api.h"
#include "vl53l8cx_plugin_detection_thresholds.h"
#include "vl53l8cx_plugin_motion_indicator.h"
#include "vl53l8cx_plugin_xtalk.h"

/*
 * LOCAL PATCH (VL53L8CX carrier Rev 2).
 * On this carrier NCS_S drives both the sensor NCS and U3.OE (via U5). The
 * stock library asserts CS and clocks immediately, so the first SCLK edge can
 * arrive before the translators enable and the first bit is lost. Insert a
 * settle delay after CS-low. Sketches check this macro to detect an unpatched
 * library copy (see code/teensy4/README.md).
 */
#ifndef VL53L8CX_CS_SETTLE_US
#define VL53L8CX_CS_SETTLE_US 1
#endif
#if VL53L8CX_CS_SETTLE_US < 1
#error "VL53L8CX_CS_SETTLE_US must be >= 1 for the OE->NCS_S carrier"
#endif

/*
 * LOCAL PATCH (VL53L8CX carrier Rev 2).
 * The stock I2C IO_Read retries a NACKed address phase forever. A missing,
 * unpowered or mis-strapped sensor (SPI_I2C_N still high) therefore hangs
 * setup() instead of returning an error the sketch can handle. Bound it.
 */
#ifndef VL53L8CX_I2C_NACK_RETRIES
#define VL53L8CX_I2C_NACK_RETRIES 5
#endif

/* Class Declaration ---------------------------------------------------------*/
class VL53L8CX {
  public:
    VL53L8CX(TwoWire *i2c, int lpn_pin, int i2c_rst_pin = -1);
    VL53L8CX(SPIClass *spi, int cs_pin, int lpn_pin = -1, int i2c_rst_pin = -1, uint32_t spi_speed = 5000000);
    virtual ~VL53L8CX(void);
    virtual int begin(uint16_t new_i2c_address = VL53L8CX_DEFAULT_I2C_ADDRESS);
    virtual int end(void);
    virtual void on(void);
    virtual void off(void);
    virtual void i2c_reset(void);
    uint8_t is_alive(uint8_t *p_is_alive);
    uint8_t init(void);
    uint8_t set_i2c_address(uint16_t i2c_address);
    uint8_t get_power_mode(uint8_t *p_power_mode);
    uint8_t set_power_mode(uint8_t power_mode);
    uint8_t start_ranging(void);
    uint8_t stop_ranging(void);
    uint8_t check_data_ready(uint8_t *p_isReady);
    uint8_t get_ranging_data(VL53L8CX_ResultsData *p_results);
    uint8_t get_resolution(uint8_t *p_resolution);
    uint8_t set_resolution(uint8_t resolution);
    uint8_t get_ranging_frequency_hz(uint8_t *p_frequency_hz);
    uint8_t set_ranging_frequency_hz(uint8_t frequency_hz);
    uint8_t get_integration_time_ms(uint32_t *p_time_ms);
    uint8_t set_integration_time_ms(uint32_t integration_time_ms);
    uint8_t get_sharpener_percent(uint8_t *p_sharpener_percent);
    uint8_t set_sharpener_percent(uint8_t sharpener_percent);
    uint8_t get_target_order(uint8_t *p_target_order);
    uint8_t set_target_order(uint8_t target_order);
    uint8_t get_ranging_mode(uint8_t *p_ranging_mode);
    uint8_t set_ranging_mode(uint8_t ranging_mode);
    uint8_t get_external_sync_pin_enable(uint8_t *p_is_sync_pin_enabled);
    uint8_t set_external_sync_pin_enable(uint8_t enable_sync_pin);
    uint8_t get_VHV_repeat_count(uint32_t *p_repeat_count);
    uint8_t set_VHV_repeat_count(uint32_t repeat_count);
    uint8_t dci_read_data(uint8_t *data, uint32_t index, uint16_t data_size);
    uint8_t dci_write_data(uint8_t *data, uint32_t index, uint16_t data_size);
    uint8_t dci_replace_data(uint8_t *data, uint32_t index, uint16_t data_size, uint8_t *new_data, uint16_t new_data_size, uint16_t new_data_pos);
    uint8_t get_detection_thresholds_enable(uint8_t *p_enabled);
    uint8_t set_detection_thresholds_enable(uint8_t enabled);
    uint8_t get_detection_thresholds(VL53L8CX_DetectionThresholds *p_thresholds);
    uint8_t set_detection_thresholds(VL53L8CX_DetectionThresholds *p_thresholds);
    uint8_t get_detection_thresholds_auto_stop(uint8_t *p_auto_stop);
    uint8_t set_detection_thresholds_auto_stop(uint8_t auto_stop);
    uint8_t motion_indicator_init(VL53L8CX_Motion_Configuration *p_motion_config, uint8_t resolution);
    uint8_t motion_indicator_set_distance_motion(VL53L8CX_Motion_Configuration  *p_motion_config, uint16_t distance_min_mm, uint16_t distance_max_mm);
    uint8_t motion_indicator_set_resolution(VL53L8CX_Motion_Configuration *p_motion_config, uint8_t resolution);
    uint8_t calibrate_xtalk(uint16_t reflectance_percent, uint8_t nb_samples, uint16_t distance_mm);
    uint8_t get_caldata_xtalk(uint8_t *p_xtalk_data);
    uint8_t set_caldata_xtalk(uint8_t *p_xtalk_data);
    uint8_t get_xtalk_margin(uint32_t *p_xtalk_margin);
    uint8_t set_xtalk_margin(uint32_t xtalk_margin);

    /**
     * @brief Utility function to read data.
     * @param  RegisterAddr: specifies internal address register to be read.
     * @param  p_values: pointer to data to be read.
     * @param  size: number of bytes to be read.
     * @retval 0 if ok, an error code otherwise.
     */
    uint8_t IO_Read(uint16_t RegisterAddress, uint8_t *p_values, uint32_t size)
    {
      if (dev_i2c) {
        int status = 0;
        uint8_t buffer[2];
        // LOCAL PATCH: bounded retry (stock code loops forever on a NACK).
        for (uint8_t attempt = 0; ; attempt++) {
          dev_i2c->beginTransmission((uint8_t)((_dev.platform.address >> 1) & 0x7F));
          // Target register address for transfer
          buffer[0] = (uint8_t)(RegisterAddress >> 8);
          buffer[1] = (uint8_t)(RegisterAddress & 0xFF);
          dev_i2c->write(buffer, 2);
          status = dev_i2c->endTransmission(false);
          if (status == 0) {
            break;
          }
          // Fix for some STM32 boards
          // Reinitialize the i2c bus with the default parameters
#ifdef ARDUINO_ARCH_STM32
          if (status) {
            dev_i2c->end();
            dev_i2c->begin();
          }
#endif
          // End of fix
          if (attempt + 1 >= VL53L8CX_I2C_NACK_RETRIES) {
            return 1;   // LOCAL PATCH: report the failure to the caller
          }
          delayMicroseconds(100);
        }
        uint32_t i = 0;
        if (size > DEFAULT_I2C_BUFFER_LEN) {
          while (i < size) {
            // If still more than DEFAULT_I2C_BUFFER_LEN bytes to go, DEFAULT_I2C_BUFFER_LEN,
            // else the remaining number of bytes
            uint8_t current_read_size = (size - i > DEFAULT_I2C_BUFFER_LEN ? DEFAULT_I2C_BUFFER_LEN : size - i);
            // LOCAL PATCH: a zero-length requestFrom means the address phase
            // NACKed, so the sensor's internal pointer did not advance and the
            // chunk can be retried safely. A short (partial) chunk cannot: the
            // pointer moved for every byte clocked out, so abort.
            uint8_t got = 0;
            for (uint8_t chunk_attempt = 0; ; chunk_attempt++) {
              got = (uint8_t)dev_i2c->requestFrom(((uint8_t)((_dev.platform.address >> 1) & 0x7F)), current_read_size);
              if (got != 0) break;
              if (chunk_attempt + 1 >= VL53L8CX_I2C_NACK_RETRIES) {
                return 1;
              }
              delayMicroseconds(100);
            }
            while (dev_i2c->available()) {
              p_values[i] = dev_i2c->read();
              i++;
            }
            // LOCAL PATCH: leave the driver with a definite error instead of
            // spinning in the while(i < size) loop.
            if (got != current_read_size) {
              return 1;
            }
          }
        } else {
          // LOCAL PATCH: same zero-length retry as the chunked path. A NACKed
          // address phase clocks no bytes, so the pointer did not move and the
          // read is replayable. A short read is caught by `return i != size`.
          for (uint8_t attempt = 0; ; attempt++) {
            if (dev_i2c->requestFrom(((uint8_t)((_dev.platform.address >> 1) & 0x7F)), size) != 0) {
              break;
            }
            if (attempt + 1 >= VL53L8CX_I2C_NACK_RETRIES) {
              return 1;
            }
            delayMicroseconds(100);
          }
          while (dev_i2c->available()) {
            p_values[i] = dev_i2c->read();
            i++;
          }
        }
        return i != size;
      }
      if (dev_spi) {
        uint32_t position = 0;
        uint32_t data_size = 0;
        uint16_t    temp;
        // LOCAL PATCH: IO_Read only sends the 2-byte command header, so a full
        // chunk-sized buffer here would waste ~1 KB of stack for nothing.
        uint8_t data_write[2];
        for (position = 0; position < size; position += VL53L8CX_COMMS_CHUNK_SIZE) {
          if (size > VL53L8CX_COMMS_CHUNK_SIZE) {
            if ((position + VL53L8CX_COMMS_CHUNK_SIZE) > size) {
              data_size = size - position;
            } else {
              data_size = VL53L8CX_COMMS_CHUNK_SIZE;
            }
          } else {
            data_size = size;
          }
          temp = RegisterAddress + position;
          data_write[0] = SPI_READ_MASK(temp) >> 8;
          data_write[1] = SPI_READ_MASK(temp) & 0xFF;
          dev_spi->beginTransaction(SPISettings(spi_speed, MSBFIRST, SPI_MODE3));
          digitalWrite(cs_pin, LOW);
          // LOCAL PATCH: let U5/U3 enable before the first SCLK edge.
          delayMicroseconds(VL53L8CX_CS_SETTLE_US);
          dev_spi->transfer(data_write, 2);
          for (uint16_t i = 0; i < data_size; i++) {
            *(p_values + i + position) = dev_spi->transfer(0x00);
          }
          digitalWrite(cs_pin, HIGH);
          dev_spi->endTransaction();
        }
        return 0;
      }
      return 1;
    }

    /**
     * @brief Utility function to write data.
     * @param  RegisterAddr: specifies internal address register to be written.
     * @param  p_values: pointer to data to be written.
     * @param  size: number of bytes to be written.
     * @retval 0 if ok, an error code otherwise.
     */
    uint8_t IO_Write(uint16_t RegisterAddress, uint8_t *p_values, uint32_t size)
    {
      if (dev_i2c) {
        uint32_t i = 0;
        uint8_t buffer[2];
        uint8_t err = 0;   // LOCAL PATCH: report the first failed chunk
        while (i < size) {
          // If still more than DEFAULT_I2C_BUFFER_LEN bytes to go, DEFAULT_I2C_BUFFER_LEN,
          // else the remaining number of bytes
          size_t current_write_size = (size - i > DEFAULT_I2C_BUFFER_LEN ? DEFAULT_I2C_BUFFER_LEN : size - i);
          dev_i2c->beginTransmission((uint8_t)((_dev.platform.address >> 1) & 0x7F));
          // Target register address for transfer
          buffer[0] = (uint8_t)((RegisterAddress + i) >> 8);
          buffer[1] = (uint8_t)((RegisterAddress + i) & 0xFF);
          dev_i2c->write(buffer, 2);
          if (dev_i2c->write(p_values + i, current_write_size) == 0) {
            return 1;
          } else {
            i += current_write_size;
            if (size - i) {
              // Flush buffer and send stop bit so we have compatibility also with ESP32 platforms
              uint8_t st = (uint8_t)dev_i2c->endTransmission(true);
              // LOCAL PATCH: a NACK mid-download used to be invisible here; the
              // sensor's firmware CRC was the only backstop.
              if (st != 0 && err == 0) err = st;
            }
          }
        }
        uint8_t last = (uint8_t)dev_i2c->endTransmission(true);
        return (err != 0) ? err : last;
      }

      if (dev_spi) {

        uint8_t status = 0;
        uint32_t i = 0;
        uint32_t position = 0;
        uint32_t data_size = 0;
        uint16_t    temp;
        uint8_t data_write[VL53L8CX_COMMS_CHUNK_SIZE + 2];
        for (position = 0; position < size; position += VL53L8CX_COMMS_CHUNK_SIZE) {
          if (size > VL53L8CX_COMMS_CHUNK_SIZE) {
            if ((position + VL53L8CX_COMMS_CHUNK_SIZE) > size) {
              data_size = size - position;
            } else {
              data_size = VL53L8CX_COMMS_CHUNK_SIZE;
            }
          } else {
            data_size = size;
          }
          temp = RegisterAddress + position;
          data_write[0] = SPI_WRITE_MASK(temp) >> 8;
          data_write[1] = SPI_WRITE_MASK(temp) & 0xFF;
          for (i = 0; i < data_size; i++) {
            data_write[i + 2] = p_values[position + i];
          }
          data_size += 2;
          dev_spi->beginTransaction(SPISettings(spi_speed, MSBFIRST, SPI_MODE3));
          digitalWrite(cs_pin, LOW);
          // LOCAL PATCH: let U5/U3 enable before the first SCLK edge.
          delayMicroseconds(VL53L8CX_CS_SETTLE_US);
          dev_spi->transfer(data_write, data_size);
          digitalWrite(cs_pin, HIGH);
          dev_spi->endTransaction();
        }
        return status;
      }
      return 1;
    }

    /**
     * @brief Utility function to wait.
     * @param  ms: milliseconds to wait.
     * @retval 0
     */
    uint8_t IO_Wait(uint32_t ms)
    {
      delay(ms);
      return 0;
    }

  private:

    /* Helper classes. */
    TwoWire *dev_i2c;
    SPIClass *dev_spi;

    /* Configuration */
    int cs_pin;
    int  lpn_pin;
    int i2c_rst_pin;
    uint32_t spi_speed;

    VL53L8CX_Configuration _dev;
    VL53L8CX_Configuration *p_dev;
};


#ifdef __cplusplus
extern "C" {
#endif

uint8_t VL53L8CX_io_write(void *handle, uint16_t RegisterAddress, uint8_t *p_values, uint32_t size);
uint8_t VL53L8CX_io_read(void *handle, uint16_t RegisterAddress, uint8_t *p_values, uint32_t size);
uint8_t VL53L8CX_io_wait(void *handle, uint32_t ms);

#ifdef __cplusplus
}
#endif

#endif /* __VL53L8CX_H */
