sabinM1/VL53L8CX-carrier/(commit log)

2026-11-08 Add project README and schematic/PCB design guide
    Document the five-carrier VL53L8CX array for the Teensy 4.0: system
    overview, component tables, operating modes, pin maps and bring-up
    thresholds. Add a step-by-step schematic and PCB guide covering the
    carrier netlist, sensor land pattern and thermal pad, routing rules,
    assembly limits and a layout review checklist.
    Record the round-11 verification result (47 PASS / 10 NV / 0 FAIL) in
    the design proposal and review context.
    [VL53L8CX_HelloWorld_I2C.ino, VL53L8CX_HelloWorld_SPI.ino, VL53L8CX_ThresholdDetection.ino, mode_a_single_bus.ino, single_sensor_bringup.ino, vl53l8cx.h, vl53l8cx_api.c]
2026-11-08 Add machine-readable BOM with carrier and system rows
    [BOM.csv]
2026-11-08 Verify component datasheets and fill BOM part numbers
    Close the U5 and MIC5504 pin-number items from the supplied datasheets, correct the LDO accuracy to +/-3 % over temperature, and flag the 10 kohm R6 part as superseded by 6.8 kohm. Record MPNs in BOM.csv, marking the parts that still need sourcing.
    [BOM.csv]
2026-11-08 Record sourced parts and fix component datasheet filenames
    Add the VL53L8CX, J1 header, 6.8 kohm R6 and TPS22918-Q1 to the BOM, close the load-switch residual from its datasheet, and note that QOD must be tied to VOUT. Rename the nine component datasheets so each filename matches its content.
    [BOM.csv]
2026-11-08 Fix the load-switch configuration in the docs
    State the TPS22918-Q1 wiring as a fixed pin table: CT open with no footprint, QOD strapped to VOUT, 100 kohm on ON. Correct the claim that the switching tables' 1430 us t_ON applies at CT = 0 and restate the on-resistance drop per temperature.
    [BOM.csv]
2026-11-08 Close the last pre-layout document checks
    Three independent checks passed: U3 RSV pinout matches TI Figure 4-3, the PH1-06-UA is a straight 1.02 mm-hole header with 3 A contacts and no moulded pin-1 mark, and V0GC/1 carries a liner that must come off after reflow. Record the J1 footprint, the pin-1 silkscreen requirement and the liner step.
    [BOM.csv]
2026-11-08 Close pre-layout audit findings
    F1/F2 settled from DS14161 Table 3: RSVD1-3 to GND and C1 SPI_I2C_N as the I2C-mode reset. Firmware prints an all -1 line at the frame cadence, makes one boot attempt, probes 3x in the bring-up sketch, and init() exits early on a failed poll so a wedged sensor is bounded to ~4.8 s. Add an 'r' forced re-init command for the R4 bench test. Rename the datasheets to match their content and correct the stale BOM/doc numbers.
    [BOM.csv]
2026-11-08 Add execution checklist for build and bring-up
    Covers tooling (including what the LogicAnalyzer V6.0 can and cannot measure), remaining procurement, schematic and PCB order of work, assembly, bench phases B0-B9 with R2-R9 pass criteria, and the definition of done.
2026-11-08 Record portable scope coverage in checklist
    200 kHz / 2.5 MS/s DSO closes R2 and R6 (with a probe-loading caveat) and the load-switch edges; R7 still needs a 20 MHz scope and R8 stays on the logic analyzer.
2026-11-08 Add measurement matrix to checklist
    Lists every build/bench measurement, its target, the instrument, and whether the current kit covers it. Only the Mode B I2C rise time needs a scope faster than 200 kHz.
2026-11-08 Remove Mode B implementation, keep docs
    Delete the mode_b_multi_bus sketch and the Mode B BOM/docs artifacts from the build path. Mode B and C remain documented in the README, firmware README and Design_proposal; only Mode A is implemented. Both remaining sketches recompiled unchanged.
    [BOM.csv]
2026-11-08 Apply final revision fixes
    Mark the design document as Teensy 4.0 with an RP2350 history banner, correct the 100 nF MPN to the catalog-valid K tolerance part, restrict the I2C buffer guard to __IMXRT1062__, and clean the SPI transfer calls. Both sketches recompiled unchanged.
    [BOM.csv]
2026-11-08 Clarify historical host-change row
    Row 2 describes the Rev 2 move to RP2350; mark it as reverted to Teensy 4.0 in Rev 3+ instead of inverting the historical direction.
2026-11-09 Move the load switch onto each carrier
    Each carrier now carries its own TPS22918 between J1-1 and the rest, so a
    power cycle removes AVDD and 1V8 together, the drop falls from 40-80 mV to
    ~5 mV, and the external switch board is gone. J1 becomes 1x7 (adds
    RAIL_EN); per-board count goes 20 -> 22 with U10 and C10. The 3.3 V source
    is now a Pololu #5266 3S buck (DC1) with CB1 at its input.
    Firmware is unchanged: same pin, same polarity, same ordering rule.
    [BOM.csv]
2026-11-09 Change the carrier header to a 2x4
    J1 moves from the 1x7 PH1-07-UA to the dual-row 2x4 PH2-08-UA.
    Pin 3 becomes a second GND, the 7.62 mm pin span shortens the board by
    about 7.6 mm, and an 8-way IDC socket gives the harness a keyed plug.
    All pin numbers shift by one from SCLK onward (SCLK 4, MOSI 5, MISO 6,
    NCS 7, RAIL_EN 8). No firmware change.
    [BOM.csv]
